MrScottFletcher/project-derek/qlcplus/Derek-Animation-Catalog-v03.md

# Derek animation catalog v03 â€” independent U1, U2, and U3 vibe libraries

v03 contains the same 51 one-shot vibe chasers for each universe: `LIB U1 Vibe`, `LIB U2 Vibe`, and `LIB U3 Vibe`. Each instance is independent and controls only its own cluster controller plus its eight Derek fixtures.

## Operator controls

- The existing `Animation Library - U1 Pilot` page remains available for U1 pilot functions.
- `Vibe Library - U1`, `Vibe Library - U2`, and `Vibe Library - U3` Virtual Console pages each provide Park/Blackout plus all 51 vibe buttons.
- Do not run two functions for the same universe at the same time. Different universe functions can run independently.

## Content and timing

Each universe has Angry, Aggressive, Nervous, Happy, Fun, Celebration, Reverent, Sad, Welcoming, Chaotic, Cheering, Zombie, Super Hero, Patriotic, Playful, Rainbow Fun, and Sparkle Ponies; each has three variations. Cue steps are at most 3.6 seconds and variations run approximately 10, 15, or 22 seconds. Every chaser ends in that universe's Park/Blackout pose.

## Required commissioning

U2 and U3 use raw DMX center 128 and the U1 physical direction convention (192 = left; 64 = right) as initial generated values. These are **not physically verified U2/U3 calibrations**. Before live playback, run each universe's Park/Blackout and a short vibe with clear mechanical travel, then record and apply any per-Derek center/direction corrections.
