MrScottFletcher/project-derek/qlcplus/Derek-Animation-Catalog-v04.md

# Derek animation catalog v04 â€” all-universe scenes

v04 retains all independent U1/U2/U3 libraries and adds 51 all-universe **SCENE** functions. Each is a QLC+ Show with three parallel tracks: U1 begins first, U2 follows after a small offset, and U3 follows after twice that offset. This makes the clusters feel independently active while using the same named vibe and variation. No QLC+ audio functions or cluster audio triggers are included.

Use the Scene Library - All Universes Virtual Console page for PARK ALL / BLACKOUT and the 51 themed scenes. Do not launch a scene alongside an independent function for U1, U2, or U3, because they own the same channels.

| Scene ID | Vibe | Variation | Name | U2/U3 offset | Total runtime |
| ---: | --- | ---: | --- | ---: | ---: || 1115 | Aggressive | 1 | Challenge | 500 ms | 10.7 s |
| 1116 | Aggressive | 2 | Charge | 900 ms | 16.6 s |
| 1117 | Aggressive | 3 | Dominance | 1300 ms | 24.9 s |
| 1118 | Angry | 1 | Glare | 500 ms | 10.7 s |
| 1119 | Angry | 2 | Boil | 900 ms | 16.6 s |
| 1120 | Angry | 3 | Red Storm | 1300 ms | 24.9 s |
| 1121 | Celebration | 1 | Gold Rise | 500 ms | 10.7 s |
| 1122 | Celebration | 2 | Confetti Sweep | 900 ms | 16.6 s |
| 1123 | Celebration | 3 | Grand Toast | 1300 ms | 24.9 s |
| 1124 | Chaotic | 1 | Mayhem | 500 ms | 10.7 s |
| 1125 | Chaotic | 2 | Crossfire | 900 ms | 16.6 s |
| 1126 | Chaotic | 3 | Everything Everywhere | 1300 ms | 24.9 s |
| 1127 | Cheering | 1 | Go Team | 500 ms | 10.7 s |
| 1128 | Cheering | 2 | Victory Wave | 900 ms | 16.6 s |
| 1129 | Cheering | 3 | Roar | 1300 ms | 24.9 s |
| 1130 | Fun | 1 | Wiggle | 500 ms | 10.7 s |
| 1131 | Fun | 2 | Color Chase | 900 ms | 16.6 s |
| 1132 | Fun | 3 | Party Peek | 1300 ms | 24.9 s |
| 1133 | Happy | 1 | Sunrise | 500 ms | 10.7 s |
| 1134 | Happy | 2 | Bouncy Hello | 900 ms | 16.6 s |
| 1135 | Happy | 3 | Bright Smile | 1300 ms | 24.9 s |
| 1136 | Nervous | 1 | Fidget | 500 ms | 10.7 s |
| 1137 | Nervous | 2 | Worry Scan | 900 ms | 16.6 s |
| 1138 | Nervous | 3 | Jitter | 1300 ms | 24.9 s |
| 1139 | Patriotic | 1 | Stars | 500 ms | 10.7 s |
| 1140 | Patriotic | 2 | Stripes | 900 ms | 16.6 s |
| 1141 | Patriotic | 3 | Finale | 1300 ms | 24.9 s |
| 1142 | Playful | 1 | Peekaboo | 500 ms | 10.7 s |
| 1143 | Playful | 2 | Tease | 900 ms | 16.6 s |
| 1144 | Playful | 3 | Goofy Wave | 1300 ms | 24.9 s |
| 1145 | Rainbow Fun | 1 | Rainbow Hello | 500 ms | 10.7 s |
| 1146 | Rainbow Fun | 2 | Prism Parade | 900 ms | 16.6 s |
| 1147 | Rainbow Fun | 3 | Rainbow Riot | 1300 ms | 24.9 s |
| 1148 | Reverent | 1 | Candle Watch | 500 ms | 10.7 s |
| 1149 | Reverent | 2 | Quiet Vigil | 900 ms | 16.6 s |
| 1150 | Reverent | 3 | Procession | 1300 ms | 24.9 s |
| 1151 | Sad | 1 | Blue Sigh | 500 ms | 10.7 s |
| 1152 | Sad | 2 | Lonely Look | 900 ms | 16.6 s |
| 1153 | Sad | 3 | Rainfall | 1300 ms | 24.9 s |
| 1154 | Sparkle Ponies | 1 | Twinkle Trot | 500 ms | 10.7 s |
| 1155 | Sparkle Ponies | 2 | Magic Mane | 900 ms | 16.6 s |
| 1156 | Sparkle Ponies | 3 | Glitter Gallop | 1300 ms | 24.9 s |
| 1157 | Super Hero | 1 | Hero Rise | 500 ms | 10.7 s |
| 1158 | Super Hero | 2 | Sky Patrol | 900 ms | 16.6 s |
| 1159 | Super Hero | 3 | Power Pose | 1300 ms | 24.9 s |
| 1160 | Welcoming | 1 | Warm Hello | 500 ms | 10.7 s |
| 1161 | Welcoming | 2 | Open House | 900 ms | 16.6 s |
| 1162 | Welcoming | 3 | Come Closer | 1300 ms | 24.9 s |
| 1163 | Zombie | 1 | Crawl | 500 ms | 10.7 s |
| 1164 | Zombie | 2 | Graveyard Scan | 900 ms | 16.6 s |
| 1165 | Zombie | 3 | Undead Swarm | 1300 ms | 24.9 s |

## Audio handoff

The scene timing above is intentionally independent of audio. Add a QLC+ audio function or a cluster-controller DFPlayer trigger to a fourth Show track when the track numbers and desired cue points are confirmed. Preserve the existing three motion tracks and their stagger offsets.
