MrScottFletcher/project-derek/3d-files/DerekCanLidAssembly_75_v1_Ring_v8-Perfect-for-some-cans.stl

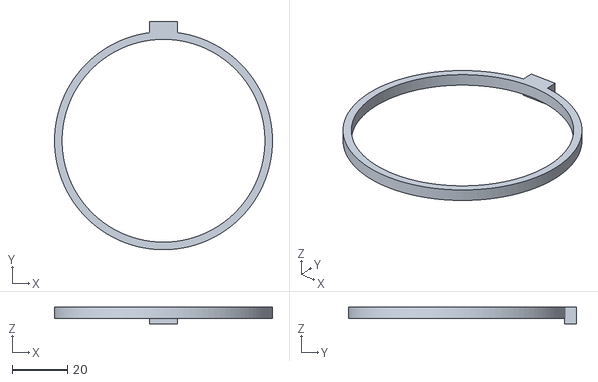
[picture p1: CAD file, 2026-08-20]
3d-files/DerekCanLidAssembly_75_v1_Ring_v8-Perfect-for-some-cans.stl
79.0 x 82.8 x 6.00
