MrScottFletcher/project-derek/3d-files/DerekCanLidAssembly_75_v1_Ring_v10_x3.3mf

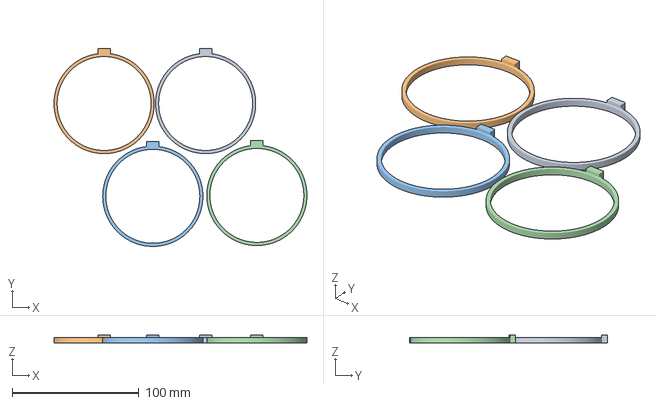
[picture p2: CAD file, 2026-08-20]
3d-files/DerekCanLidAssembly_75_v1_Ring_v10_x3.3mf
199.4 x 155.9 x 6.00 mm
DerekCanLidAssembly_75_v1_Ring_v10.stl x 4
