MrScottFletcher/project-derek/3d-files/DerekCanLidAssembly_85_v1 v17_1mm_Trans_qty1.3mf

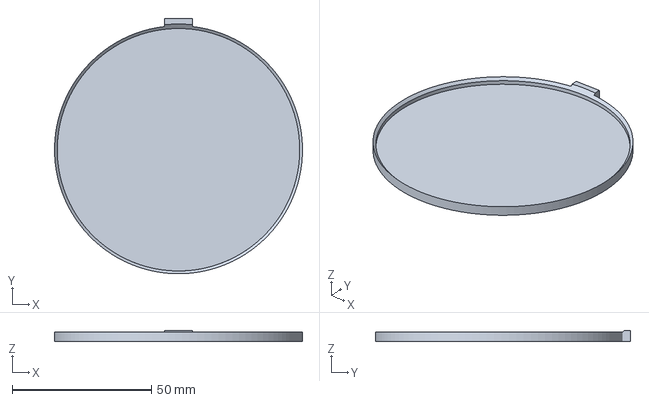
[picture p3: CAD file, 2026-08-20]
3d-files/DerekCanLidAssembly_85_v1 v17_1mm_Trans_qty1.3mf
89.0 x 91.6 x 4.00 mm
