MrScottFletcher/project-derek/3d-files/DerekCanLidAssembly_75_v1_Lid_v6_x4.3mf

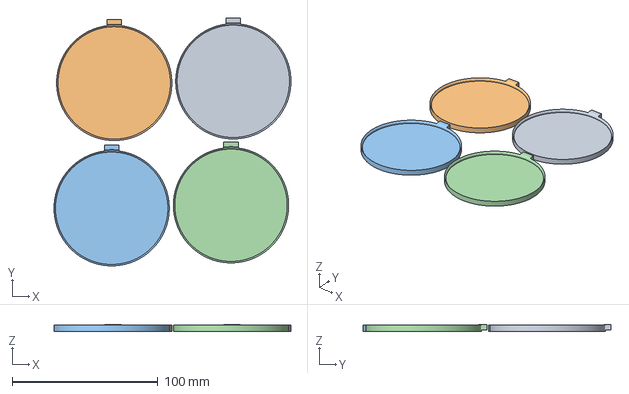
[picture p4: CAD file, 2026-08-20]
3d-files/DerekCanLidAssembly_75_v1_Lid_v6_x4.3mf
162.3 x 169.8 x 5.00 mm
DerekCanLidAssembly_75_v1_Lid_v6.stl x 4
