MrScottFletcher/project-derek/3d-files/Chassis Derek Can Assembly 1 v17 - qty07- 1mm new clearance.3mf

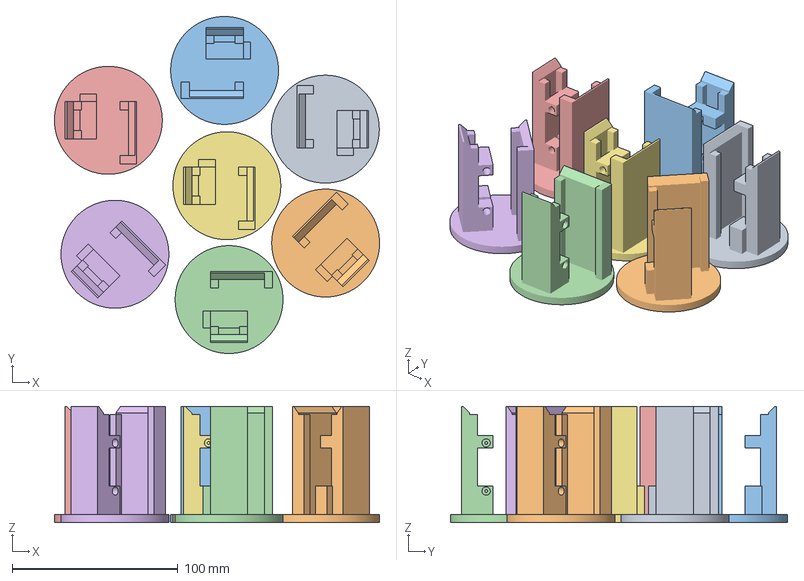
[picture p5: CAD file, 2026-08-20]
3d-files/Chassis Derek Can Assembly 1 v17 - qty07- 1mm new clearance.3mf
195.9 x 203.1 x 70.0 mm
Carriage Derek Can Assembly 1 v17 - 1mm new clearance.stl
Carriage Derek Can Assembly 1 v17 - 1mm new clearance.stl 1
Carriage Derek Can Assembly 1 v17 - 1mm new clearance.stl 2 x 2
Carriage Derek Can Assembly 1 v17 - 1mm new clearance.stl 3
Carriage Derek Can Assembly 1 v17 - 1mm new clearance.stl 4
Carriage Derek Can Assembly 1 v17 - 1mm new clearance.stl 5
