MrScottFletcher/project-derek/3d-files/DerekCanLidAssembly_85_v1_Ring_v15_x3.3mf

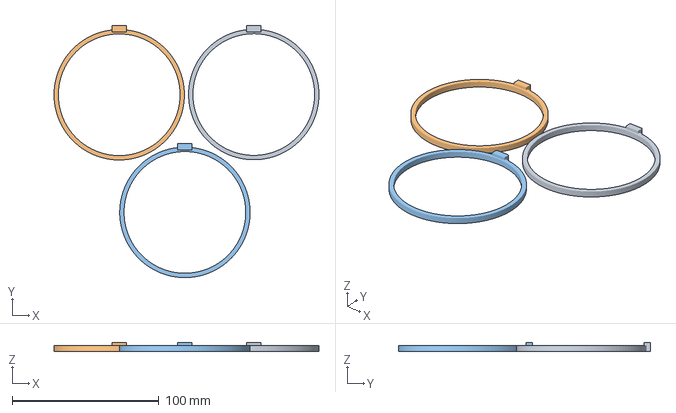
[picture p6: CAD file, 2026-08-20]
3d-files/DerekCanLidAssembly_85_v1_Ring_v15_x3.3mf
180.8 x 172.0 x 6.00 mm
DerekCanLidAssembly_85_v1_Ring_v15.stl x 3
