MrScottFletcher/project-derek/3d-files/DerekCanLidAssembly_75_v1_Lid_v11_1mmThick_Transparent_01.3mf

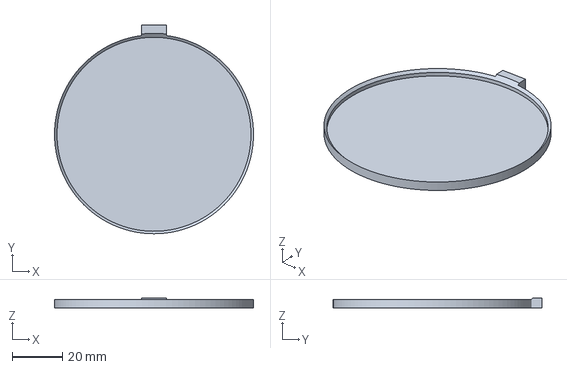
[picture p7: CAD file, 2026-08-20]
3d-files/DerekCanLidAssembly_75_v1_Lid_v11_1mmThick_Transparent_01.3mf
79.0 x 82.8 x 4.00 mm
