MrScottFletcher/project-derek/3d-files/Carriage Derek Can Assembly 1 v17 - 1mm new clearance.3mf

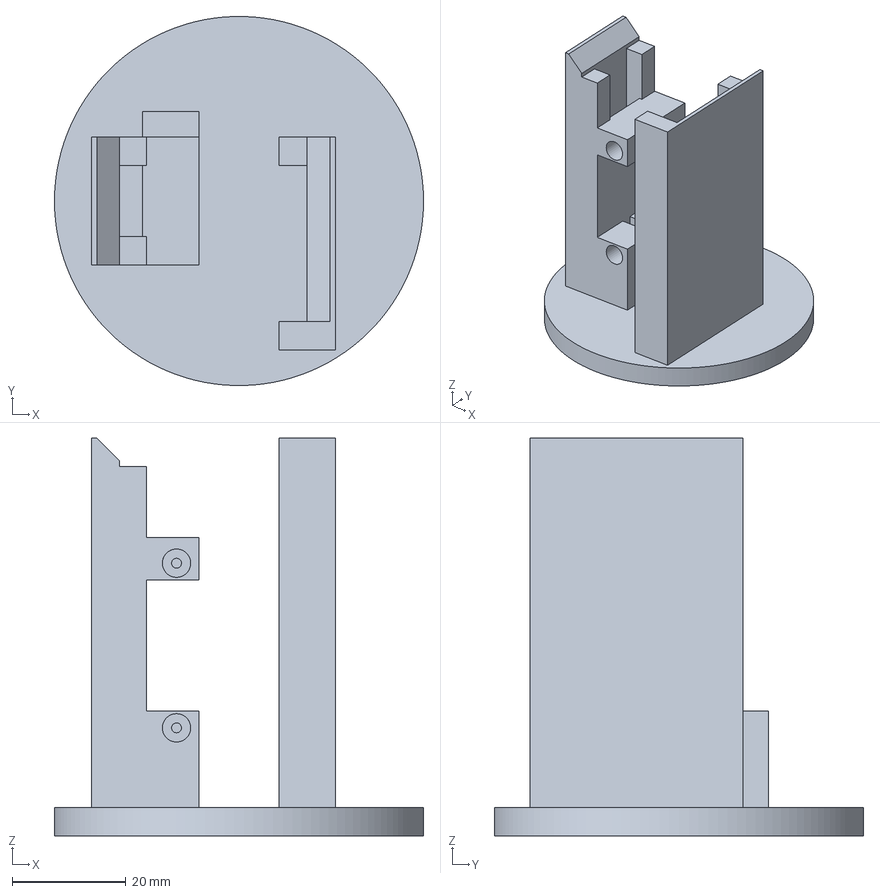
[picture p8: CAD file, 2026-08-20]
3d-files/Carriage Derek Can Assembly 1 v17 - 1mm new clearance.3mf
65.0 x 65.0 x 70.0 mm
