MrScottFletcher/project-derek/3d-files/DerekCanLidAssembly_85_v1_Lid_v15_Trans_x3.3mf

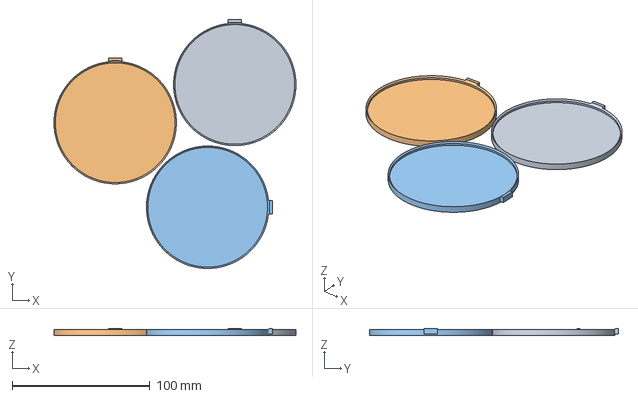
[picture p9: CAD file, 2026-08-20]
3d-files/DerekCanLidAssembly_85_v1_Lid_v15_Trans_x3.3mf
175.9 x 181.0 x 5.00 mm
DerekCanLidAssembly_85_v1_Lid_v15.stl x 3
