MrScottFletcher/project-derek/3d-files/DerekCanLidAssembly_75_v1_Ring_v8_x3-Perfect-for-some-cans.stl.3mf

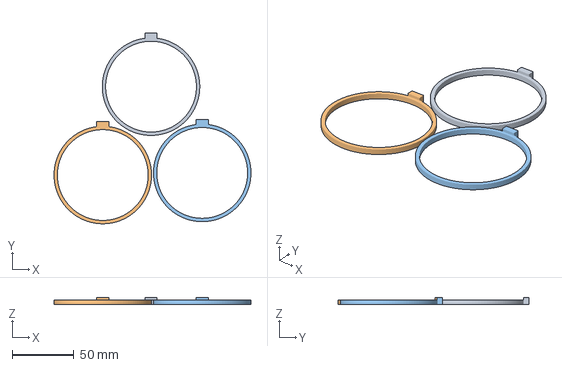
[picture p10: CAD file, 2026-08-20]
3d-files/DerekCanLidAssembly_75_v1_Ring_v8_x3-Perfect-for-some-cans.stl.3mf
159.5 x 154.4 x 6.00 mm
DerekCanLidAssembly_75_v1_Ring_v8.stl x 3
