MrScottFletcher/project-derek/3d-files/DerekCanLidAssembly_85_v1_Ring_v15.3mf

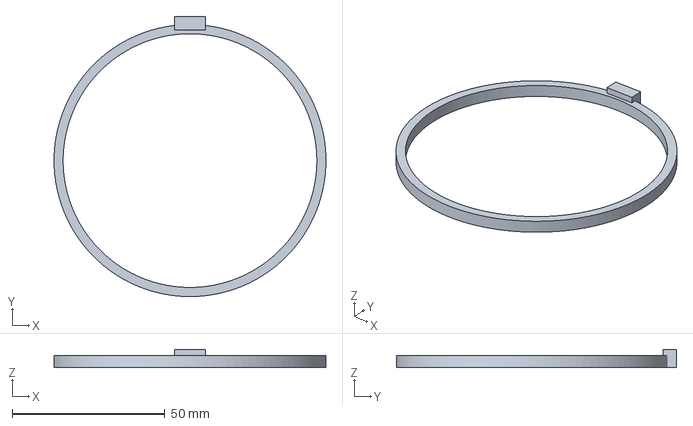
[picture p11: CAD file, 2026-08-20]
3d-files/DerekCanLidAssembly_85_v1_Ring_v15.3mf
89.0 x 91.6 x 6.00 mm
