MrScottFletcher/project-derek/3d-files/DerekCanLidAssembly_85_v1_Lid_v15_Trans_x1.3mf

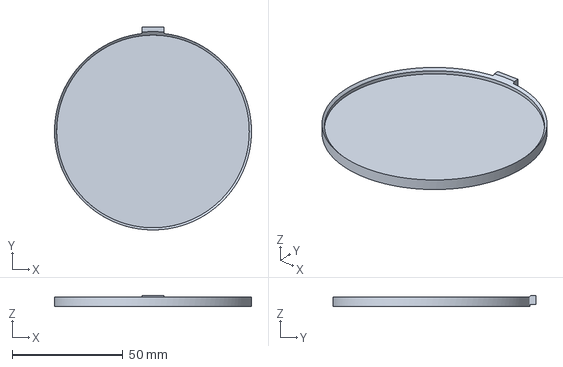
[picture p12: CAD file, 2026-08-20]
3d-files/DerekCanLidAssembly_85_v1_Lid_v15_Trans_x1.3mf
89.0 x 91.7 x 5.00 mm
