MrScottFletcher/project-derek/3d-files/DerekCanLidAssembly_75_v1_Ring_v9.3mf

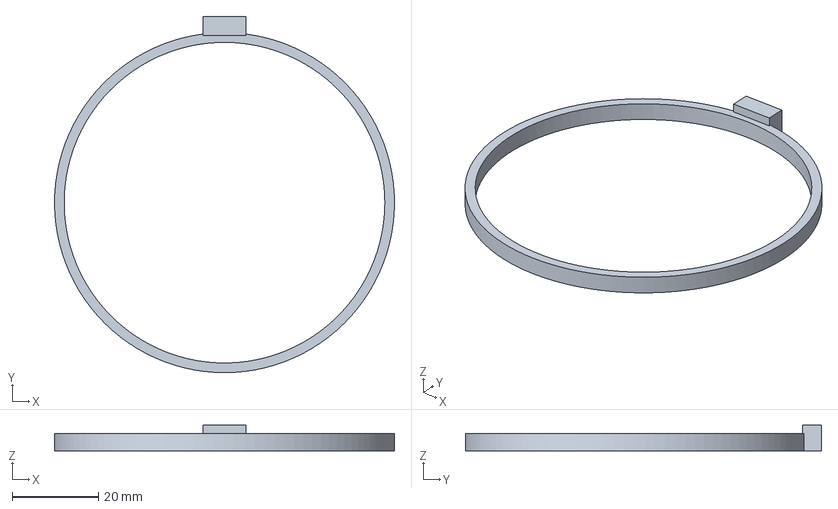
[picture p13: CAD file, 2026-08-20]
3d-files/DerekCanLidAssembly_75_v1_Ring_v9.3mf
79.0 x 82.8 x 6.00 mm
