MrScottFletcher/project-derek/3d-files/Chassis Derek Can Assembly 1 v19 qty7 - more space for carriage.3mf

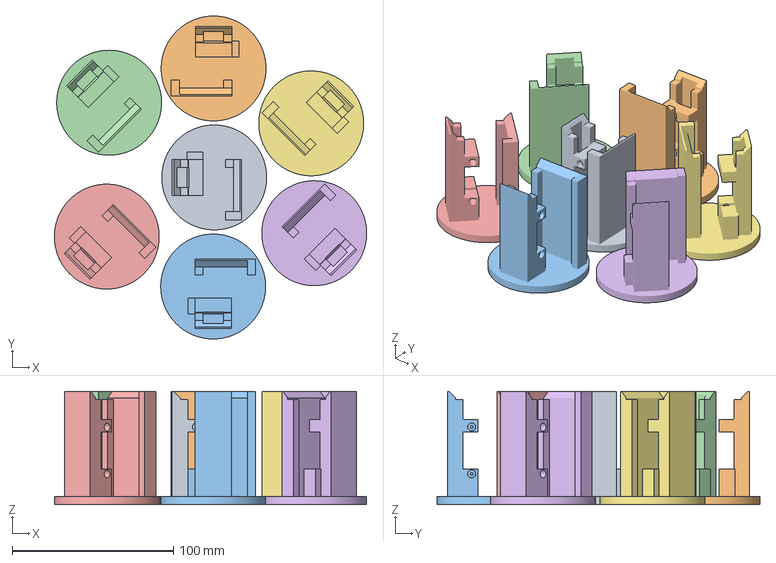
[picture p14: CAD file, 2026-08-20]
3d-files/Chassis Derek Can Assembly 1 v19 qty7 - more space for carriage.3mf
193.5 x 200.1 x 70.0 mm
Chassis Derek Can Assembly 1 v19 - more space for carriage.stl x 7
