MrScottFletcher/project-derek/3d-files/Spur Gear 15 Derek Can Assembly 1 v15.stl

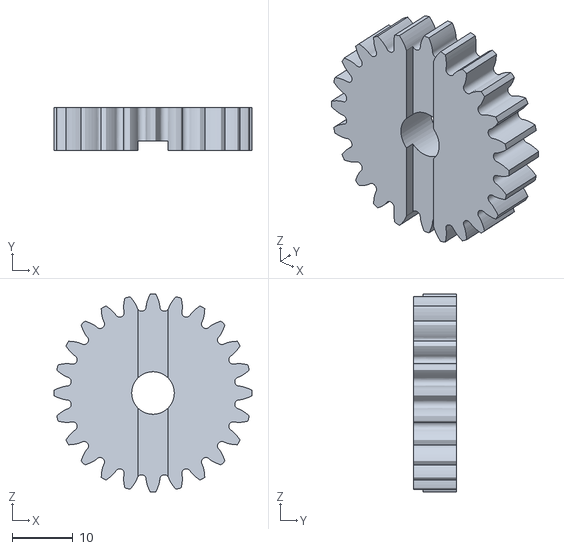
[picture p16: CAD file, 2026-08-07]
3d-files/Spur Gear 15 Derek Can Assembly 1 v15.stl
32.5 x 7.00 x 32.5
