MrScottFletcher/project-derek/3d-files/DerekCanLidAssembly_75_v1_Lid_v6.stl

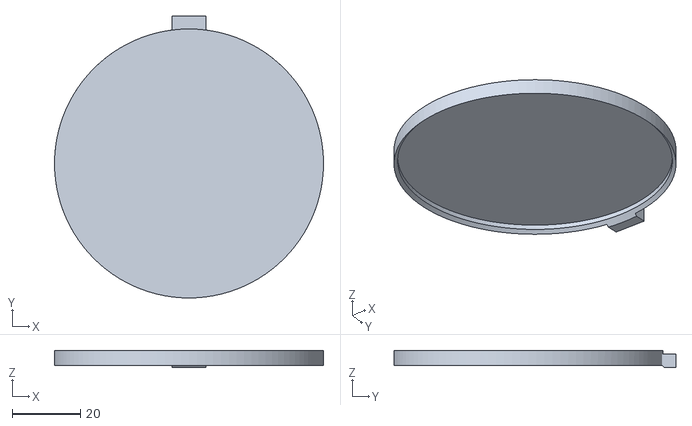
[picture p17: CAD file, 2026-08-07]
3d-files/DerekCanLidAssembly_75_v1_Lid_v6.stl
79.0 x 82.8 x 5.00
