MrScottFletcher/project-derek/3d-files/Mech_Carriage 15 Derek Can Assembly 1 v15.stl

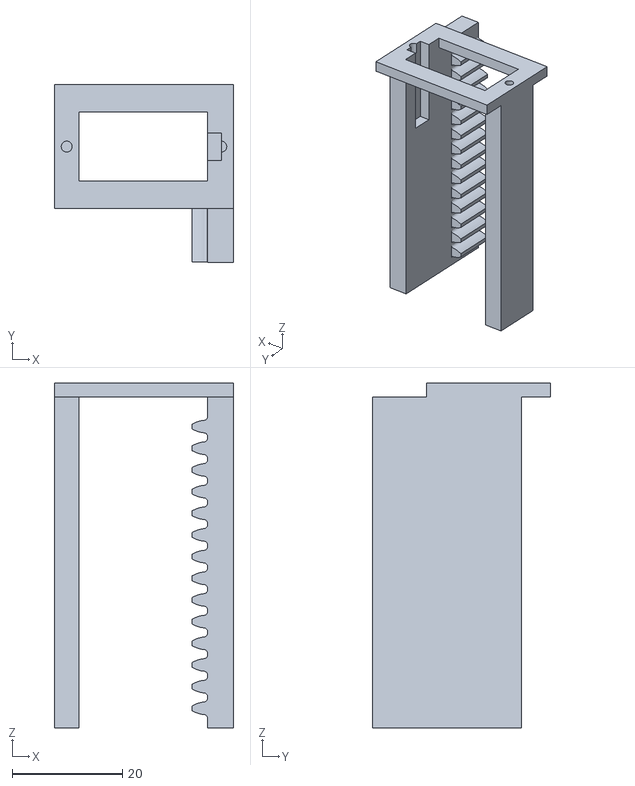
[picture p18: CAD file, 2026-08-07]
3d-files/Mech_Carriage 15 Derek Can Assembly 1 v15.stl
32.5 x 32.2 x 62.5
