MrScottFletcher/project-derek/3d-files/DerekCan_Platform_75_SpotWIRECover_v11.stl

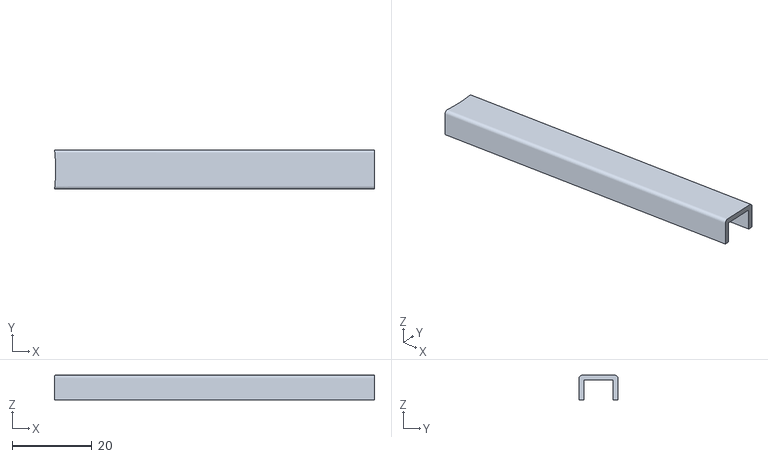
[picture p20: CAD file, 2026-09-27]
3d-files/DerekCan_Platform_75_SpotWIRECover_v11.stl
80.5 x 9.80 x 6.20
