MrScottFletcher/project-derek/3d-files/DerekCan_Platform_75 v5.stl

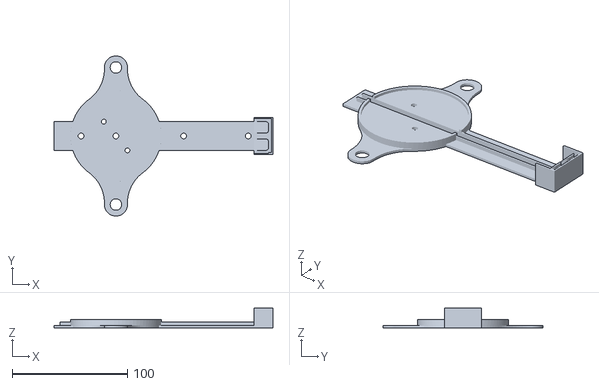
[picture p21: CAD file, 2026-09-27]
3d-files/DerekCan_Platform_75 v5.stl
190.2 x 139.0 x 17.0
