MrScottFletcher/project-derek/3d-files/Cluster Board Mount Plate v5 220x220.stl

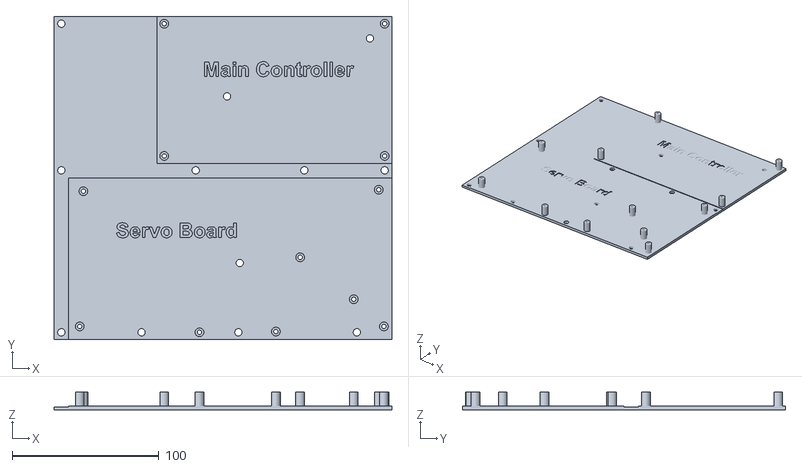
[picture p22: CAD file, 2026-09-27]
3d-files/Cluster Board Mount Plate v5 220x220.stl
230.0 x 220.0 x 12.0
