MrScottFletcher/project-derek/3d-files/Servo Horn EyeCoil_A v9 CloserToPin_qty33.3mf

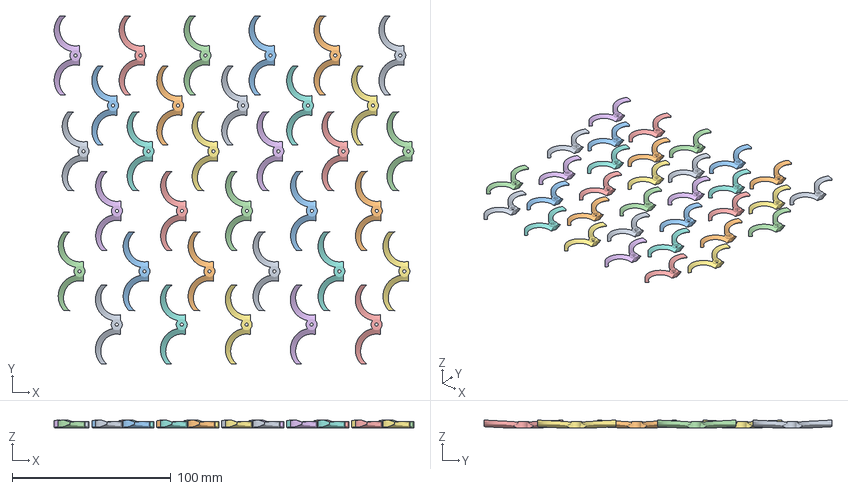
[picture p23: CAD file, 2026-09-27]
3d-files/Servo Horn EyeCoil_A v9 CloserToPin_qty33.3mf
226.5 x 219.1 x 5.08 mm
Servo Horn EyeCoil_A v9 CloserToPin.stl x 6
Servo Horn EyeCoil_A v9 CloserToPin.stl 1 x 6
Servo Horn EyeCoil_A v9 CloserToPin.stl 4 x 6
Servo Horn EyeCoil_A v9 CloserToPin.stl 6 x 6
Servo Horn EyeCoil_A v9 CloserToPin.stl 11 x 6
Servo Horn EyeCoil_A v9 CloserToPin.stl 14 x 3
