MrScottFletcher/project-derek/3d-files/Audio Amp Box A v3.stl

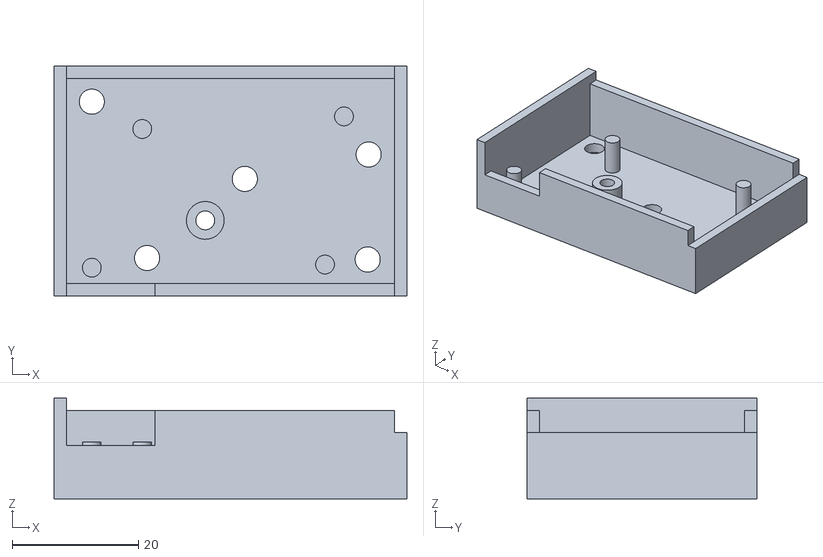
[picture p24: CAD file, 2026-09-27]
3d-files/Audio Amp Box A v3.stl
56.0 x 36.5 x 16.0
