MrScottFletcher/project-derek/3d-files/DerekCan_Platform_75_SpotCover_NoOverhang_ v13.stl

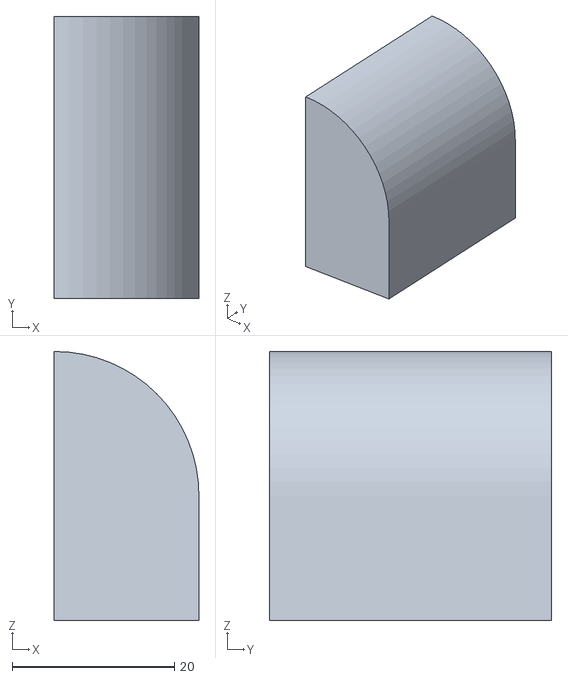
[picture p25: CAD file, 2026-09-27]
3d-files/DerekCan_Platform_75_SpotCover_NoOverhang_ v13.stl
17.9 x 34.8 x 33.2
