MrScottFletcher/project-derek/3d-files/Servo Horn EyeCoil_A v9 CloserToPin.stl

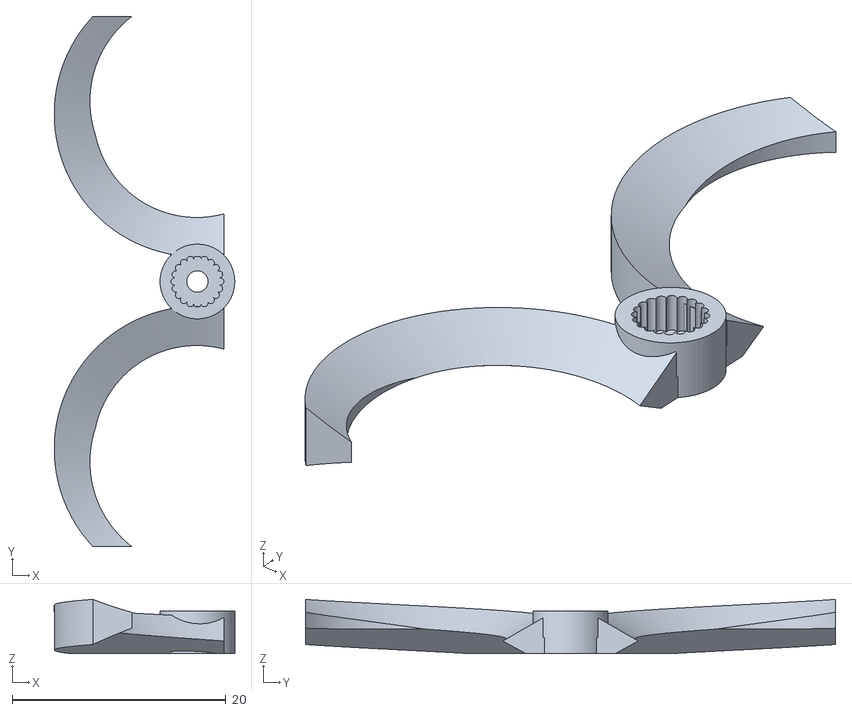
[picture p26: CAD file, 2026-09-27]
3d-files/Servo Horn EyeCoil_A v9 CloserToPin.stl
16.9 x 49.6 x 5.08
