MrScottFletcher/project-derek/3d-files/DerekCan_Platform_75 v5_qty2.3mf

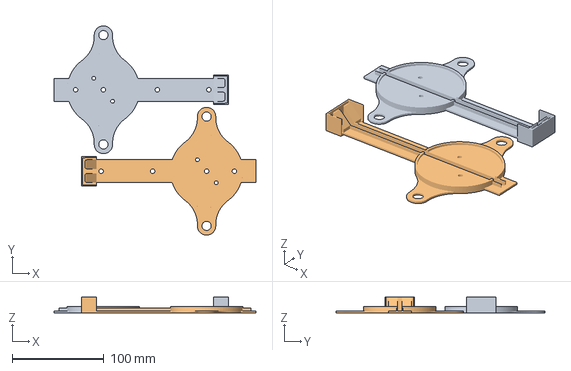
[picture p27: CAD file, 2026-09-27]
3d-files/DerekCan_Platform_75 v5_qty2.3mf
219.9 x 227.7 x 17.0 mm
DerekCan_Platform_75 v5.stl x 2
