MrScottFletcher/project-derek/3d-files/Servo Horn EyeCoil_A v8 Flattish.stl

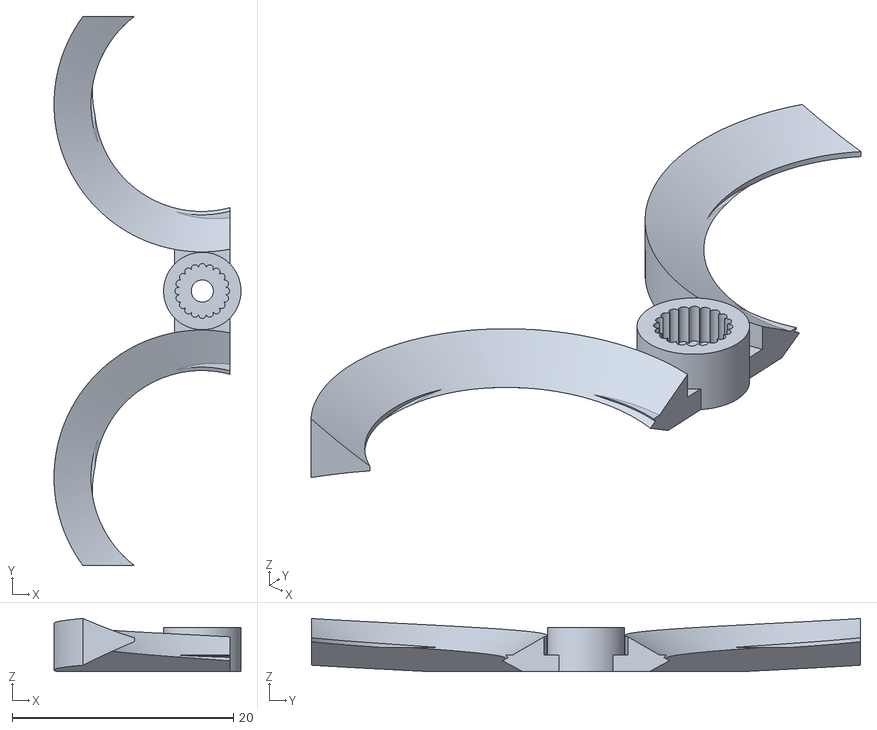
[picture p28: CAD file, 2026-09-27]
3d-files/Servo Horn EyeCoil_A v8 Flattish.stl
16.9 x 49.6 x 4.80
