MrScottFletcher/project-derek/3d-files/Servo Horn Eye Mount v4 xLots.3mf

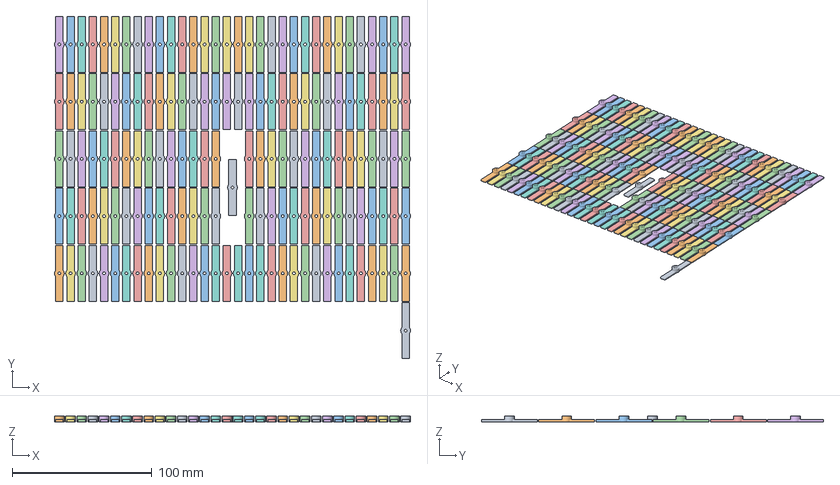
[picture p29: CAD file, 2026-08-20]
3d-files/Servo Horn Eye Mount v4 xLots.3mf
255.0 x 245.0 x 4.00 mm
Servo Horn Eye Mount v4 Test1.stl
Servo Horn Eye Mount v4 Test1.stl -1 x 157
