MrScottFletcher/project-derek/3d-files/Servo Horn Pinion Gear Mount v1.stl

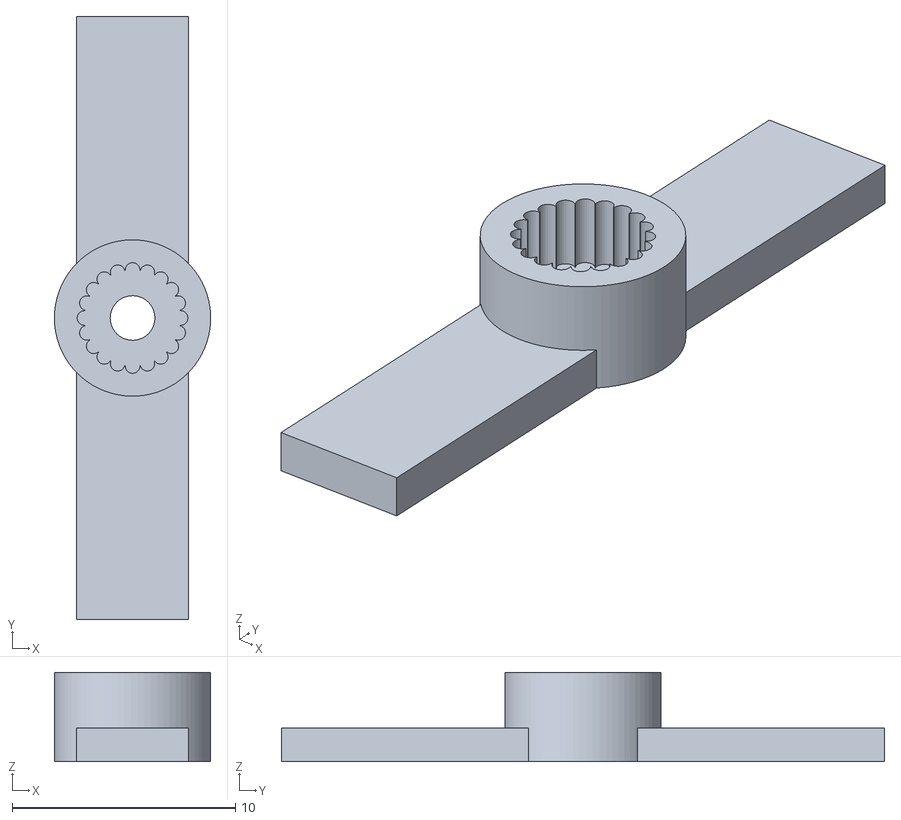
[picture p30: CAD file, 2026-08-20]
3d-files/Servo Horn Pinion Gear Mount v1.stl
7.00 x 27.0 x 4.00
