MrScottFletcher/project-derek/3d-files/Servo Horn Eye Mount ExtendedHub v1 v1.stl

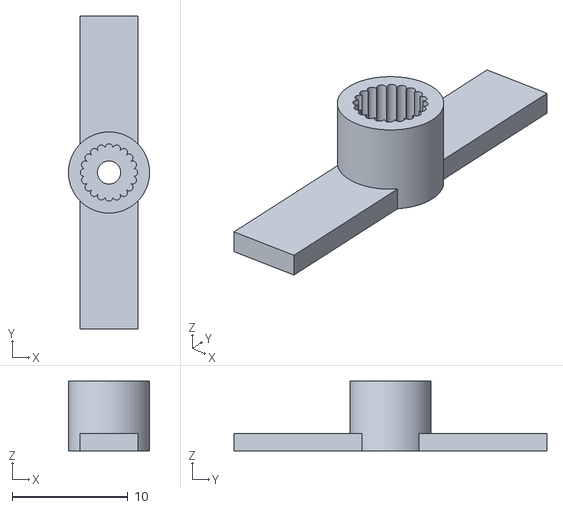
[picture p31: CAD file, 2026-08-20]
3d-files/Servo Horn Eye Mount ExtendedHub v1 v1.stl
7.00 x 27.0 x 6.00
