MrScottFletcher/project-derek/(list of files, cad)

Other CAD files:
3d-files/DerekCanLidAssembly_75_v1_Ring_v8-Perfect-for-some-cans.stl.3mf
3d-files/Chassis Derek Can Assembly 1 v17 - 1mm new clearance.3mf
3d-files/DerekCanLidAssembly_85_v1_Lid_v15.3mf
3d-files/Chassis Derek Can Assembly 1 v19 - more space for carriage.3mf
3d-files/Mech_Chassis 15 Derek Can Assembly 1 v15.stl
3d-files/Chassis Derek Can Assembly 1 v17 - 1mm new clearance.stl
3d-files/Chassis Derek Can Assembly 1 v19 - more space for carriage.stl
3d-files/DerekCanLidAssembly_75_v1_Ring_v10.stl
3d-files/DerekCanLidAssembly_75_v1_Ring_v9.stl
3d-files/DerekCanLidAssembly_85_v1_Lid_v15.stl
3d-files/DerekCanLidAssembly_85_v1_Ring_v15.stl
