MrScottFletcher/project-derek/print/MrLabel_MR610_LibreOffice.odt

Mr-Label

Mr-Label

Mr-Label

Mr-Label

Mr-Label

Mr-Label

Mr-Label

Mr-Label

Mr-Label

Mr-Label

Mr-Label

Mr-Label

Mr-Label

Mr-Label

Mr-Label

Mr-Label

Mr-Label

Mr-Label

Mr-Label

Mr-Label

Mr-Label

Mr-Label

Mr-Label

Mr-Label

Mr-Label

Mr-Label

Mr-Label

Mr-Label

Mr-Label

Mr-Label

Mr-Label

Mr-Label

Mr-Label

Mr-Label

Mr-Label

Mr-Label

Mr-Label

Mr-Label

Mr-Label

Mr-Label

Mr-Label

Mr-Label

Mr-Label

Mr-Label

Mr-Label

Mr-Label

Mr-Label

Mr-Label

Mr-Label

Mr-Label

Mr-Label

Mr-Label

Mr-Label

Mr-Label

Mr-Label

Mr-Label

Mr-Label

Mr-Label

Mr-Label

Mr-Label

Mr-Label

Mr-Label

Mr-Label

Mr-Label
