MrScottFletcher/project-derek/print/MrLabel_MR610_LibreOffice_CanLabels_U1-4.odt

U1 -1

U1 -1

U1 -2

U1 -2

U1 -3

U1 -3

U1 -4

U1 -4

U1 -5

U1 -5

U1 -6

U1 -6

U1 -7

U1 -7

U1 -8

U1 -8

U2 -1

U2 -1

U2 -2

U2 -2

U2 -3

U2 -3

U2 -4

U2 -4

U2 -5

U2 -5

U2 -6

U2 -6

U2 -7

U2 -7

U2 -8

U2 -8

U3 -1

U3 -1

U3 -2

U3 -2

U3 -3

U3 -3

U3 -4

U3 -4

U3 -5

U3 -5

U3 -6

U3 -6

U3 -7

U3 -7

U3 -8

U3 -8

U4 -1

U4 -1

U4 -2

U4 -2

U4 -3

U4 -3

U4 -4

U4 -4

U4 -5

U4 -5

U4 -6

U4 -6

U4 -7

U4 -7

U4 -8

U4 -8
