MrScottFletcher/project-derek/print/MrLabel_MR610_LibreOffice_CanLabels_U5-8.odt

U5 -1

U5 -1

U5 -2

U5 -2

U5 -3

U5 -3

U5 -4

U5 -4

U5 -5

U5 -5

U5 -6

U5 -6

U5 -7

U5 -7

U5 -8

U5 -8

U6 -1

U6 -1

U6 -2

U6 -2

U6 -3

U6 -3

U6 -4

U6 -4

U6 -5

U6 -5

U6 -6

U6 -6

U6 -7

U6 -7

U6 -8

U6 -8

U7 -1

U7 -1

U7 -2

U7 -2

U7 -3

U7 -3

U7 -4

U7 -4

U7 -5

U7 -5

U7 -6

U7 -6

U7 -7

U7 -7

U7 -8

U7 -8

U8 -1

U8 -1

U8 -2

U8 -2

U8 -3

U8 -3

U8 -4

U8 -4

U8 -5

U8 -5

U8 -6

U8 -6

U8 -7

U8 -7

U8 -8

U8 -8
