MrScottFletcher/project-derek/print/MrLabel_MR610_LibreOffice_Spaced.odt

Mr-Label

Mr-Label

Mr-Label

Mr-Label

Mr-Label

Mr-Label

Mr-Label

Mr-Label

Mr-Label

Mr-Label

Mr-Label

Mr-Label

Mr-Label

Mr-Label

Mr-Label

Mr-Label

Mr-Label

Mr-Label

Mr-Label

Mr-Label

Mr-Label

Mr-Label

Mr-Label

Mr-Label

Mr-Label

Mr-Label

Mr-Label

Mr-Label

Mr-Label

Mr-Label

Mr-Label

Mr-Label

Mr-Label

Mr-Label

Mr-Label

Mr-Label

Mr-Label

Mr-Label

Mr-Label

Mr-Label

Mr-Label

Mr-Label

Mr-Label

Mr-Label

Mr-Label

Mr-Label

Mr-Label

Mr-Label

Mr-Label

Mr-Label

Mr-Label

Mr-Label

Mr-Label

Mr-Label

Mr-Label

Mr-Label

Mr-Label

Mr-Label

Mr-Label

Mr-Label

Mr-Label

Mr-Label

Mr-Label

Mr-Label
