MrScottFletcher/project-derek/kicad/derek-can-pcb/Derek_CAN_v4.kicad_pcb

## KiCad design kicad/derek-can-pcb/Derek_CAN_v4.kicad_pcb (2026-08-16)

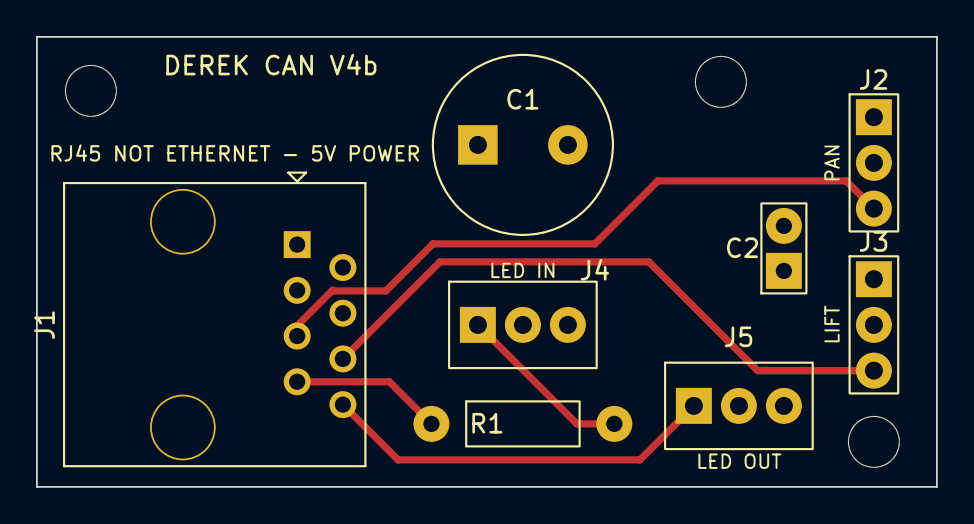
[picture p43: board Derek_CAN_v4.kicad_pcb from above]

Board: 4 copper layers, 50.0 x 25.0 mm, 8 parts (0 on the bottom side), 7 nets.

Parts:
C1: 1000uF 16V; CP_Radial_D10.0mm_P5.00mm
C2: 100nF 50V X7R; C_Disc_D5.0mm_W2.5mm_P2.50mm
J1: FMHXG_RJ45NMCCFC; RJ45_OST_PJ012-8P8CX_Vertical
J2: PAN_SERVO; PinHeader_1x03_P2.54mm_Vertical
J3: LIFT_SERVO; PinHeader_1x03_P2.54mm_Vertical
J4, J5: JST-XH-3; JST_XH_B3B-XH-A_1x03_P2.50mm_Vertical
R1: 330R; R_Axial_DIN0207_L6.3mm_D2.5mm_P10.16mm_Horizontal

Connections:
5V: C1.1 (+), C2.1, J1.1, J1.2, J2.2 (+5V), J3.2 (+5V), J4.2 (+5V), J5.2 (+5V)
GND: C1.2 (-), C2.2, J1.3, J1.4, J2.1 (GND), J3.1 (GND), J4.3 (GND), J5.3 (GND)
LED_FROM_CLUSTER: J1.7, R1.1
LED_RETURN_CLUSTER: J1.8, J5.1 (DATA)
LED_TO_FIRST: J4.1 (DATA), R1.2
LIFT_PWM: J1.6, J3.3 (SIGNAL)
PAN_PWM: J1.5, J2.3 (SIGNAL)
