MrScottFletcher/project-derek/kicad/cluster_split_kicad_revC/Cluster_Logic_Board/Cluster_Logic_Board.kicad_pcb

## KiCad design kicad/cluster_split_kicad_revC/Cluster_Logic_Board/Cluster_Logic_Board.kicad_pcb (2026-08-16)

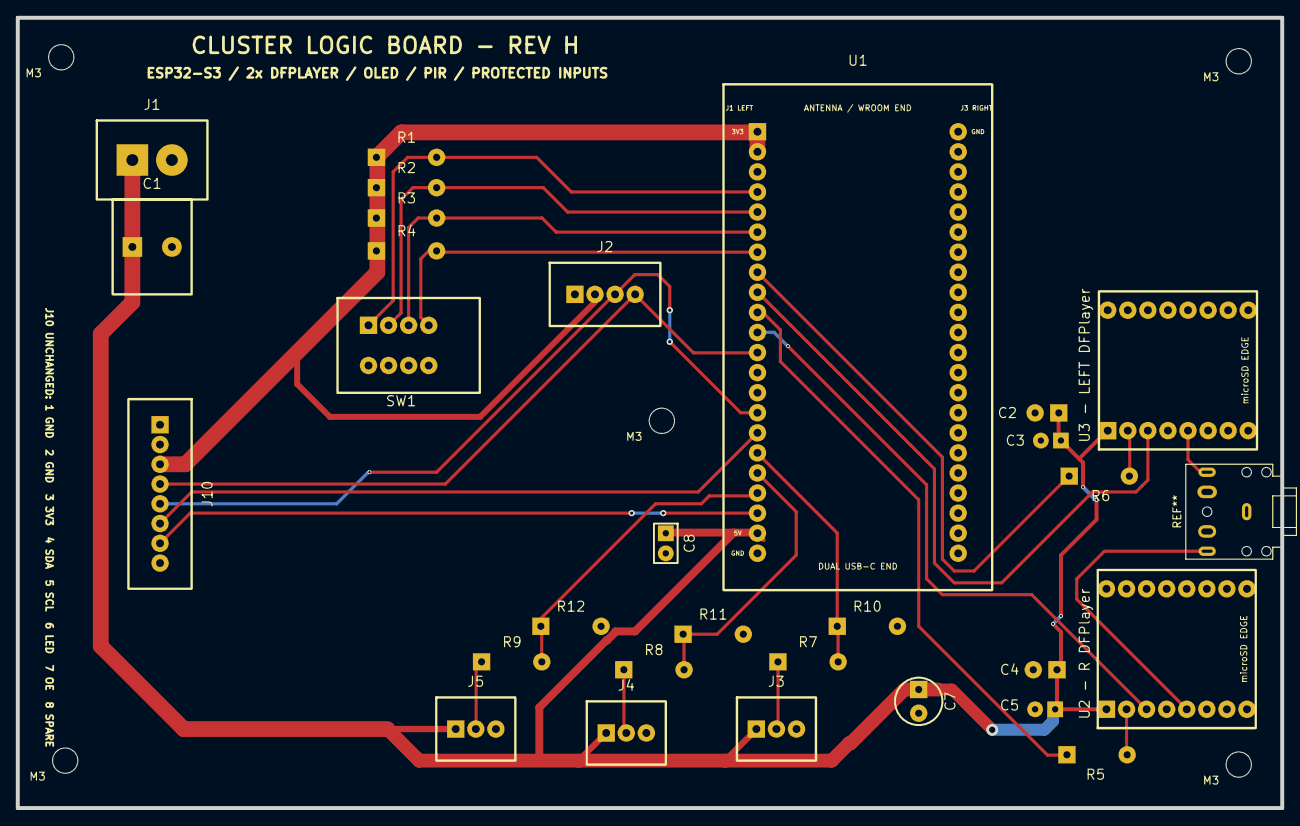
[picture p44: board Cluster_Logic_Board.kicad_pcb from above]

Board: 2 copper layers, 160.0 x 100.0 mm, 34 parts (0 on the bottom side), 23 nets.

Parts:
C1: 1000uF_10V
C2, C4: 47uF 10V; C_Radial_47uF
C3, C5: 100nF; C_Ceramic_100nF
C7: 47uF 10V ESP32; C_Radial_47uF
C8: 100nF ESP32; C_Ceramic_100nF
J1: POWER_5V
J2: OLED_1x4
J3: PIR_LEFT
J4: PIR_CENTER
J5: PIR_RIGHT
J10: JST_XH_8
M3, M3#2, M3#3, M3#4, M3#5: MountingHole_3.2mm_M3
R1, R2, R3, R4: 10k; R_Axial_10k
R5: 1k DF1 RX; R_Axial_1k
R6: 1k DF2 RX; R_Axial_1k
R7: 1k PIR L; R_Axial_1k
R8: 1k PIR C; R_Axial_1k
R9: 1k PIR R; R_Axial_1k
R10, R11, R12: 100k; R_Axial_100k
SW1: DIPSW_4
U1: Hosyond ESP32-S3 N16R8 44-pin DevKit; Hosyond_ESP32-S3_N16R8_44P
U2 - R DFPlayer, U3 - LEFT DFPlayer: WWZMDiB DFPlayer Mini; DFPlayer_Mini_16P

Connections:
+3V3_LOGIC: J2.2, J10.3, R1.1, R2.1, R3.1, R4.1, U1.J1.1, U1.J1.2
+5V_LOGIC: C1.1, C2.1, C3.1, C4.1, C5.1, C7.1, C8.1, J1.1, J3.1, J4.1, J5.1, U1.J1.21, U2 - R DFPlayer.1, U3 - LEFT DFPlayer.1
DF1_RX: R5.2, U2 - R DFPlayer.2
DF1_RX_ESP: R5.1, U1.J1.10
DF1_TX: U1.J1.11, U2 - R DFPlayer.3
DF2_RX: R6.2, U3 - LEFT DFPlayer.2
DF2_RX_ESP: R6.1, U1.J1.8
DF2_TX: U1.J1.9, U3 - LEFT DFPlayer.3
GND: C1.2, C2.2, C3.2, C4.2, C5.2, C7.2, C8.2, J1.2, J2.1, J3.3, J4.3, J5.3, J10.1, J10.2, R10.2, R11.2, R12.2, SW1.5, SW1.6, SW1.7, SW1.8, U1.J1.22, U1.J3.1, U1.J3.21, U1.J3.22, U2 - R DFPlayer.7, U2 - R DFPlayer.10, U3 - LEFT DFPlayer.7, U3 - LEFT DFPlayer.10
I2C_SCL: J2.3, J10.5, U1.J1.15
I2C_SDA: J2.4, J10.4, U1.J1.12
ID0: R1.2, SW1.1, U1.J1.4
ID1: R2.2, SW1.2, U1.J1.5
ID2: R3.2, SW1.3, U1.J1.6
ID3: R4.2, SW1.4, U1.J1.7
LED_DATA_3V3: J10.6, U1.J1.16
PCA_OE_N: J10.7, U1.J1.20
PIR_CENTER: R8.2, R11.1, U1.J1.18
PIR_CENTER_CONN: J4.2, R8.1
PIR_LEFT: R7.2, R10.1, U1.J1.17
PIR_LEFT_CONN: J3.2, R7.1
PIR_RIGHT: R9.2, R12.1, U1.J1.19
PIR_RIGHT_CONN: J5.2, R9.1
