MrScottFletcher/project-derek/kicad/cluster_split_kicad_revC/Cluster_Servo_Board/Cluster_Servo_Board.kicad_pcb

## KiCad design kicad/cluster_split_kicad_revC/Cluster_Servo_Board/Cluster_Servo_Board.kicad_pcb (2026-08-16)

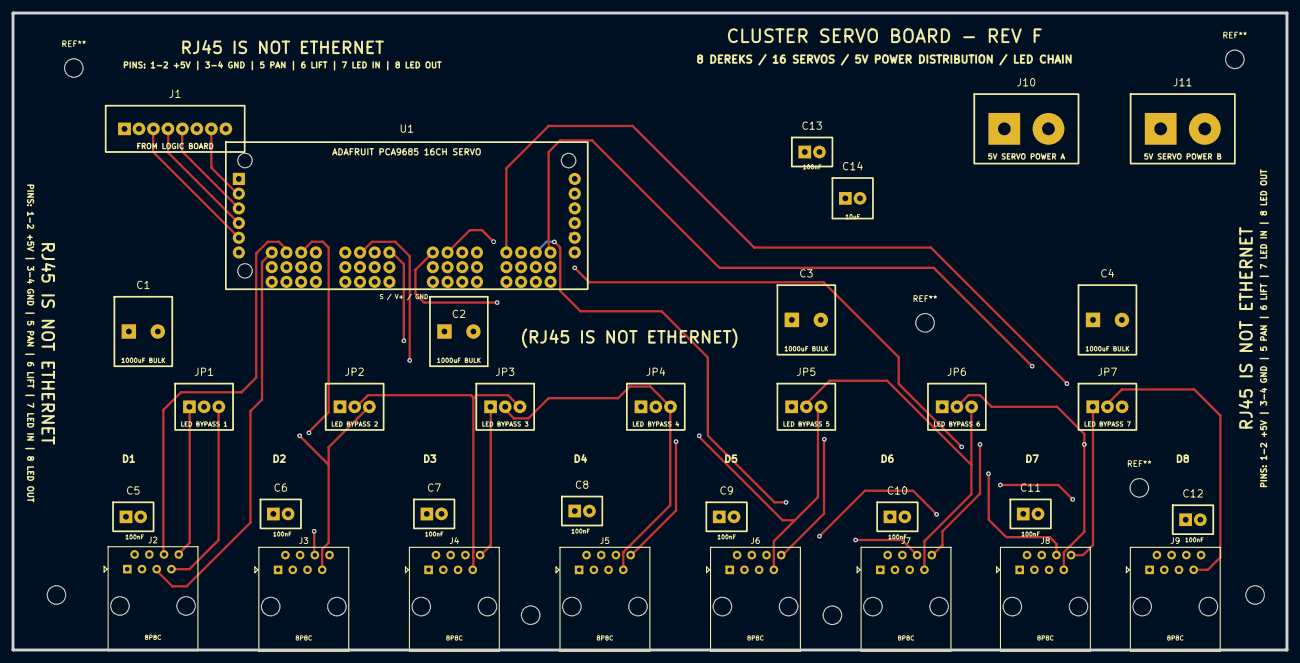
[picture p45: board Cluster_Servo_Board.kicad_pcb from above]

Board: 4 copper layers, 220.0 x 110.0 mm, 33 parts (0 on the bottom side), 37 nets.

Parts:
C1, C2, C3, C4: 1000uF_10V
C5, C6, C7, C8, C9, C10, C11, C12, C13: 100nF
C14: 10uF
J1: JST_XH_8
J2, J3, J4, J5, J6, J7, J8, J9: RJ45_Amphenol_54602-x08_Horizontal
J10, J11: POWER_5V_HICUR
JP1, JP2, JP3, JP4, JP5, JP6, JP7: LED_BYPASS
U1: ADAFRUIT_PCA9685_16CH_PRODUCT_815; Adafruit_PCA9685_16CH_Product815_Carrier

Connections:
+3V3_LOGIC: J1.3, U1.L5, U1.R5
+5V_SERVO: C1.1, C2.1, C3.1, C4.1, C5.1, C6.1, C7.1, C8.1, C9.1, C10.1, C11.1, C12.1, C13.1, C14.1, J2.1, J2.2, J3.1, J3.2, J4.1, J4.2, J5.1, J5.2, J6.1, J6.2, J7.1, J7.2, J8.1, J8.2, J9.1, J9.2, J10.1, J11.1, U1.L6, U1.R6, U1.V0, U1.V1, U1.V2, U1.V3, U1.V4, U1.V5, U1.V6, U1.V7, U1.V8, U1.V9, U1.V10, U1.V11, U1.V12, U1.V13, U1.V14, U1.V15
GND: C1.2, C2.2, C3.2, C4.2, C5.2, C6.2, C7.2, C8.2, C9.2, C10.2, C11.2, C12.2, C13.2, C14.2, J1.1, J1.2, J2.3, J2.4, J3.3, J3.4, J4.3, J4.4, J5.3, J5.4, J6.3, J6.4, J7.3, J7.4, J8.3, J8.4, J9.3, J9.4, J10.2, J11.2, U1.G0, U1.G1, U1.G2, U1.G3, U1.G4, U1.G5, U1.G6, U1.G7, U1.G8, U1.G9, U1.G10, U1.G11, U1.G12, U1.G13, U1.G14, U1.G15, U1.L1, U1.R1
I2C_SCL: J1.5, U1.L3, U1.R3
I2C_SDA: J1.4, U1.L4, U1.R4
LED_IN1: J2.7, JP1.3
LED_IN2: J3.7, JP1.2, JP2.3
LED_IN3: J4.7, JP2.2, JP3.3
LED_IN4: J5.7, JP3.2, JP4.3
LED_IN5: J6.7, JP4.2, JP5.3
LED_IN6: J7.7, JP5.2, JP6.3
LED_IN7: J8.7, JP6.2, JP7.3
LED_IN8: J9.7, JP7.2
LED_OUT1: J2.8, JP1.1
LED_OUT2: J3.8, JP2.1
LED_OUT3: J4.8, JP3.1
LED_OUT4: J5.8, JP4.1
LED_OUT5: J6.8, JP5.1
LED_OUT6: J7.8, JP6.1
LED_OUT7: J8.8, JP7.1
PCA_OE_N: J1.7, U1.L2, U1.R2
PWM0: J2.5, U1.S0
PWM1: J2.6, U1.S1
PWM2: J3.5, U1.S2
PWM3: J3.6, U1.S3
PWM4: J4.5, U1.S4
PWM5: J4.6, U1.S5
PWM6: J5.5, U1.S6
PWM7: J5.6, U1.S7
PWM8: J6.5, U1.S8
PWM9: J6.6, U1.S9
PWM10: J7.5, U1.S10
PWM11: J7.6, U1.S11
PWM12: J8.5, U1.S12
PWM13: J8.6, U1.S13
PWM14: J9.5, U1.S14
PWM15: J9.6, U1.S15
