MrScottFletcher/project-derek/derek-mcu/derek-mcu.ino

#include <Arduino.h>
#include <WiFi.h>
#include <WiFiUdp.h>
#include <Wire.h>
#include <esp_now.h>
#include <Preferences.h>

#ifndef ARDUINO_ARCH_ESP32
#error "This sketch targets ESP32-class boards."
#endif

namespace {

constexpr bool kEnableSerialLogs = true;
// Keep the serial monitor quiet during normal operation.  The `list`,
// `artnet`, `radio`, and `showstate` console commands always print on demand.
constexpr bool kEnablePeriodicSerialStatus = false;
constexpr uint8_t kSoftwareVersionMajor = 1;
constexpr uint8_t kSoftwareVersionMinor = 5;
constexpr uint8_t kSoftwareVersionRevision = 3;
constexpr uint8_t kProtocolVersion = 1;
constexpr uint16_t kProtocolMagic = 0xD311;
constexpr uint8_t kMaxClusters = 15;
constexpr uint8_t kMaxDerricks = 8;
constexpr uint8_t kBroadcastClusterId = 0xFF;
constexpr uint32_t kDiscoveryIntervalMs = 2000;
// ESP-NOW only has a small transmit queue.  During a QLC+ fade many clusters
// become dirty together, so serialize sends instead of filling that queue and
// silently losing the tail of a large update.
constexpr uint32_t kCommandIntervalMs = 5;
constexpr uint32_t kCommandHeartbeatMs = 750;
// Art-Net frames can arrive faster than the ESP-NOW scheduler can safely send
// them. Keep only the newest target and transmit it at a regular cadence,
// rather than waiting for a quiet period that would turn fades into snaps.
constexpr uint32_t kOutputFrameIntervalMs = 20;
constexpr uint32_t kStatusPageIntervalMs = 1000;
constexpr uint32_t kClusterOfflineMs = 3000;
constexpr uint32_t kBootDerekTestWaitMs = 5000;
constexpr uint32_t kBootDerekTestStepMs = 1200;
constexpr uint32_t kBootMassTestDiscoveryWaitMs = 5000;
constexpr uint32_t kBootMassTestAllUpHoldMs = 5000;
constexpr uint16_t kArtNetListenPort = 6454;
constexpr uint16_t kQlcOscPort = 7700;
const IPAddress kDefaultQlcOscHost(192, 168, 1, 149);
constexpr uint32_t kPirOscReleaseDelayMs = 75;
constexpr size_t kArtNetPacketBufferSize = 600;
constexpr uint8_t kMaxArtNetPacketsPerLoop = 16;
constexpr bool kEnableRadioDebugLogs = true;
constexpr uint32_t kRadioDebugLogIntervalMs = 1000;
constexpr uint8_t kClusterControllerChannels = 14;
constexpr uint8_t kChannelsPerDerek = 11;
constexpr uint8_t kDerekChannelsStart = kClusterControllerChannels + 1;
constexpr uint16_t kDerekOutputChannels = kMaxDerricks * kChannelsPerDerek;
constexpr uint16_t kChannelsPerCluster = kClusterControllerChannels + kDerekOutputChannels;
constexpr uint16_t kControllerActiveDerricksChannel = 1;
constexpr uint16_t kControllerApplyOutputsChannel = 2;
constexpr uint16_t kControllerEmergencyHideChannel = 3;
constexpr uint16_t kControllerRequestStatusChannel = 4;
constexpr uint16_t kControllerDiscoveryChannel = 5;
constexpr uint16_t kControllerAudioATrackMsbChannel = 6;
constexpr uint16_t kControllerAudioATrackLsbChannel = 7;
constexpr uint16_t kControllerAudioATriggerChannel = 8;
constexpr uint16_t kControllerAudioBTrackMsbChannel = 9;
constexpr uint16_t kControllerAudioBTrackLsbChannel = 10;
constexpr uint16_t kControllerAudioBTriggerChannel = 11;
constexpr uint16_t kControllerMovementSpeedChannel = 12;
constexpr uint16_t kControllerPirCenterChannel = 13;
constexpr uint16_t kControllerPirRightChannel = 14;
constexpr int8_t kI2cSdaPin = 8;
constexpr int8_t kI2cSclPin = 9;
constexpr uint8_t kOledAddress = 0x3C;
constexpr int8_t kTestModeSwitchPin = 4;
constexpr int8_t kTestAllUpButtonPin = 5;
constexpr int8_t kTestAllDownButtonPin = 6;
constexpr uint32_t kTestButtonDebounceMs = 35;
// RX480E-4 receiver inputs. Power the receiver from the MCU's 3.3 V rail so
// its D0-D3 CMOS outputs are always safe for ESP32-S3 GPIO. The receiver must
// be paired in momentary mode: a rising edge is one QLC+ show request.
// The installed fob labels run opposite the receiver's D0-D3 output order.
constexpr int8_t kRemoteButtonAPin = 18;  // RX480E D3
constexpr int8_t kRemoteButtonBPin = 17;  // RX480E D2
constexpr int8_t kRemoteButtonCPin = 16;  // RX480E D1
constexpr int8_t kRemoteButtonDPin = 15;  // RX480E D0
constexpr uint8_t kRemoteButtonCount = 4;
constexpr int8_t kRemoteButtonPins[kRemoteButtonCount] = {
    kRemoteButtonAPin, kRemoteButtonBPin, kRemoteButtonCPin, kRemoteButtonDPin};
constexpr char kRemoteButtonNames[kRemoteButtonCount] = {'A', 'B', 'C', 'D'};
constexpr uint32_t kRemoteButtonDebounceMs = 125;
constexpr uint32_t kRemoteOscReleaseDelayMs = 75;
constexpr uint8_t kDerekLiftMinimum = 0;
constexpr uint8_t kDerekLiftMaximum = 170;
constexpr uint8_t kBroadcastMac[6] = {0xFF, 0xFF, 0xFF, 0xFF, 0xFF, 0xFF};

// Fill these in for the router/network used by the QLC+ computer.
// ESP-NOW peers must share the same Wi-Fi radio channel as this connection.
constexpr char kWifiSsid[] = "DerekWifi";
constexpr char kWifiPassword[] = "derekderek";

// MCU OLED: Hosyond 2.42-inch 128x64 I2C module with an SSD1309 controller.
// Wiring on this board: GND, VCC, SCL -> GPIO9, SDA/SCA -> GPIO8.
// Test inputs use internal pull-ups: wire each switch/button from its GPIO to GND.
// GPIO4: test-mode switch; GPIO5: All Up button; GPIO6: All Down button.
constexpr int8_t kButtonNextPin = -1;
constexpr int8_t kButtonPrevPin = -1;

enum MessageKind : uint8_t {
  kMessageRegister = 1,
  kMessageCommand = 2,
  kMessageStatus = 3,
};

enum CommandFlags : uint8_t {
  kCommandFlagApplyOutputs = 1 << 0,
  kCommandFlagAudioA = 1 << 1,
  kCommandFlagAudioB = 1 << 2,
  kCommandFlagRequestStatus = 1 << 3,
  kCommandFlagEmergencyHide = 1 << 4,
  kCommandFlagDiscovery = 1 << 5,
};

enum BootDerekTestPhase : uint8_t {
  kBootDerekTestLift = 0,
  kBootDerekTestLeft = 1,
  kBootDerekTestRight = 2,
  kBootDerekTestCenter = 3,
  kBootDerekTestLower = 4,
  kBootDerekTestPhaseCount = 5,
};

enum BootMassTestPhase : uint8_t {
  kBootMassTestWaitingForClusters = 0,
  kBootMassTestAllUp = 1,
  kBootMassTestDone = 2,
};

enum MovementSpeed : uint8_t {
  kMovementSpeedFast = 0,
  kMovementSpeedMedium = 1,
  kMovementSpeedSlow = 2,
};

enum TestLiftState : uint8_t {
  kTestLiftAllDown = 0,
  kTestLiftAllUp = 1,
};

struct RgbColor {
  uint8_t r;
  uint8_t g;
  uint8_t b;
};

struct DerekCommand {
  uint8_t pan;
  uint8_t lift;
  // RGB controls map to the physical LED-chain order: spotlight (two pixels),
  // right eye (one pixel), then left eye (one pixel).
  RgbColor spotlightColor;
  RgbColor rightEyeColor;
  RgbColor leftEyeColor;
};

#pragma pack(push, 1)
struct ClusterCommandPacket {
  uint16_t magic;
  uint8_t version;
  uint8_t kind;
  uint8_t clusterId;
  uint16_t sequence;
  uint8_t flags;
  uint8_t activeDerricks;
  uint8_t movementSpeed;
  uint16_t audioTrackA;
  uint16_t audioTrackB;
  DerekCommand derricks[kMaxDerricks];
};

struct ClusterStatusPacket {
  uint16_t magic;
  uint8_t version;
  uint8_t kind;
  uint8_t clusterId;
  uint16_t sequence;
  uint8_t activeDerricks;
  uint8_t pirStateBits;
  uint16_t healthFlags;
  uint32_t uptimeMs;
  uint32_t lastCommandAgeMs;
};
#pragma pack(pop)

struct ClusterRuntime {
  bool occupied;
  bool online;
  uint8_t clusterId;
  uint8_t mac[6];
  uint16_t lastSequence;
  uint8_t lastActiveDerricks;
  uint8_t lastPirBits;
  uint16_t lastHealthFlags;
  uint32_t lastSeenAtMs;
  uint32_t lastStatusUptimeMs;
  uint16_t audioTrackASetting;
  uint16_t audioTrackBSetting;
  uint32_t lastCommandSentAtMs;
  bool audioATriggerHigh;
  bool audioBTriggerHigh;
  bool commandDirty;
  MovementSpeed movementSpeed;
  ClusterCommandPacket desiredCommand;
};

struct PendingPirOscRelease {
  bool active;
  uint8_t clusterId;
  uint8_t sensorBit;
  uint32_t dueAtMs;
};

struct PendingRemoteOscRelease {
  bool active;
  uint8_t buttonIndex;
  uint32_t dueAtMs;
};

ClusterRuntime gClusters[kMaxClusters];
uint32_t gLastDiscoveryAtMs = 0;
uint32_t gLastCommandAtMs = 0;
uint32_t gLastStatusPageAtMs = 0;
uint32_t gBootStartedAtMs = 0;
uint32_t gLastBootDerekTestStepAtMs = 0;
uint32_t gBootMassTestPhaseStartedAtMs = 0;
uint16_t gSequenceCounter = 1;
uint8_t gCurrentPage = 0;
uint8_t gBootDerekTestClusterCursor = 0;
uint8_t gBootDerekTestDerekCursor = 0;
BootDerekTestPhase gBootDerekTestPhase = kBootDerekTestLift;
bool gBootDerekTestRunning = false;
bool gBootDerekTestDone = false;
BootMassTestPhase gBootMassTestPhase = kBootMassTestWaitingForClusters;
bool gOledReady = false;
bool gTestModeEnabled = false;
bool gTestAllUpButtonWasPressed = false;
bool gTestAllDownButtonWasPressed = false;
uint32_t gTestLastButtonEventAtMs = 0;
TestLiftState gTestLiftState = kTestLiftAllDown;
bool gRemoteButtonWasPressed[kRemoteButtonCount] = {};
uint32_t gRemoteLastButtonEventAtMs[kRemoteButtonCount] = {};
int8_t gLastRemoteButtonIndex = -1;
WiFiUDP gArtNetUdp;
WiFiUDP gQlcOscUdp;
IPAddress gQlcOscHost = kDefaultQlcOscHost;
Preferences gMcuPreferences;
PendingPirOscRelease gPendingPirOscReleases[kMaxClusters * 3] = {};
PendingRemoteOscRelease gPendingRemoteOscReleases[kRemoteButtonCount] = {};
uint8_t gArtNetDmx[kMaxClusters][kChannelsPerCluster] = {};
bool gArtNetUniverseSeen[kMaxClusters] = {};
uint32_t gArtNetPacketsReceived = 0;
uint32_t gArtNetFramesAccepted = 0;
uint32_t gArtNetFramesRejected = 0;
uint32_t gLastArtNetFrameAtMs = 0;
bool gLastArtNetCommandValid = false;
uint8_t gLastArtNetCommandClusterId = 0;
uint16_t gLastArtNetCommandChannel = 0;
uint8_t gLastArtNetCommandValue = 0;
uint32_t gEspNowPacketsQueued = 0;
uint32_t gEspNowQueueFailures = 0;
uint32_t gEspNowSendSuccesses = 0;
uint32_t gEspNowSendFailures = 0;
uint32_t gLastEspNowQueuedAtMs = 0;
uint32_t gLastEspNowCallbackAtMs = 0;
uint32_t gLastRadioDebugLogAtMs = 0;
volatile bool gEspNowSendInFlight = false;
volatile int8_t gEspNowInFlightClusterIndex = -1;
volatile int8_t gEspNowFailedClusterIndex = -1;
uint8_t gNextCommandClusterIndex = 0;
uint8_t gLastEspNowClusterId = 0;
uint16_t gLastEspNowSequence = 0;
uint8_t gLastEspNowFlags = 0;
int gLastEspNowQueueResult = 0;
int gLastEspNowSendStatus = 0;
bool gClusterIdConflictDetected = false;
uint8_t gConflictClusterId = 0;
char gConflictExistingMac[18] = {};
char gConflictNewMac[18] = {};

int8_t findClusterIndexById(uint8_t clusterId);
void applyCachedArtNetUniverse(uint8_t clusterId);

bool addEspNowPeer(const uint8_t* macAddress) {
  if (esp_now_is_peer_exist(macAddress)) {
    return true;
  }

  esp_now_peer_info_t peerInfo = {};
  memcpy(peerInfo.peer_addr, macAddress, 6);
  peerInfo.channel = 0;
  peerInfo.encrypt = false;
  return esp_now_add_peer(&peerInfo) == ESP_OK;
}

void formatMac(const uint8_t* mac, char* buffer, size_t bufferLen) {
  snprintf(
      buffer,
      bufferLen,
      "%02X:%02X:%02X:%02X:%02X:%02X",
      mac[0],
      mac[1],
      mac[2],
      mac[3],
      mac[4],
      mac[5]);
}

void formatIpAddress(const IPAddress& ip, char* buffer, size_t bufferLen) {
  snprintf(buffer, bufferLen, "%u.%u.%u.%u", ip[0], ip[1], ip[2], ip[3]);
}

bool parseIpAddress(const char* text, IPAddress& ip) {
  unsigned int octets[4] = {};
  char trailing = '\0';
  if (text == nullptr || sscanf(text, "%u.%u.%u.%u%c", &octets[0], &octets[1], &octets[2], &octets[3], &trailing) != 4) {
    return false;
  }

  for (uint8_t i = 0; i < 4; ++i) {
    if (octets[i] > 255) {
      return false;
    }
  }

  ip = IPAddress(octets[0], octets[1], octets[2], octets[3]);
  return true;
}

void loadQlcOscConfiguration() {
  gMcuPreferences.begin("derek-mcu", false);

  char hostText[16] = {};
  const size_t hostLength = gMcuPreferences.getString("qlcOscHost", hostText, sizeof(hostText));
  IPAddress configuredHost;
  if (hostLength > 0 && parseIpAddress(hostText, configuredHost)) {
    gQlcOscHost = configuredHost;
  } else {
    gQlcOscHost = kDefaultQlcOscHost;
    char defaultHostText[16] = {};
    formatIpAddress(gQlcOscHost, defaultHostText, sizeof(defaultHostText));
    gMcuPreferences.putString("qlcOscHost", defaultHostText);
  }
}

bool writeOscString(const char* value) {
  if (value == nullptr) {
    return false;
  }

  const size_t valueLength = strlen(value) + 1;
  if (gQlcOscUdp.write(reinterpret_cast<const uint8_t*>(value), valueLength) != valueLength) {
    return false;
  }

  const uint8_t padding[3] = {0, 0, 0};
  const size_t paddingLength = (4 - (valueLength % 4)) % 4;
  return paddingLength == 0 || gQlcOscUdp.write(padding, paddingLength) == paddingLength;
}

bool sendQlcOscFloatEvent(const char* address, bool active) {
  if (WiFi.status() != WL_CONNECTED || address == nullptr) {
    return false;
  }

  if (!gQlcOscUdp.beginPacket(gQlcOscHost, kQlcOscPort)) {
    return false;
  }

  const uint8_t value[] = {0x3F, 0x80, 0x00, 0x00};  // OSC float32 1.0
  const uint8_t zero[] = {0x00, 0x00, 0x00, 0x00};
  const bool wrote = writeOscString(address) && writeOscString(",f") &&
                     gQlcOscUdp.write(active ? value : zero, sizeof(value)) == sizeof(value);
  if (!wrote) {
    gQlcOscUdp.endPacket();
    return false;
  }

  return gQlcOscUdp.endPacket() == 1;
}

bool sendQlcOscPirEvent(uint8_t clusterId, const char* direction, bool active) {
  if (direction == nullptr || clusterId >= kMaxClusters) {
    return false;
  }

  char address[36] = {};
  snprintf(address, sizeof(address), "/derek/pir/%u/%s", clusterId, direction);
  return sendQlcOscFloatEvent(address, active);
}

bool sendQlcOscRemoteEvent(uint8_t buttonIndex, bool active) {
  if (buttonIndex >= kRemoteButtonCount) {
    return false;
  }

  char address[20] = {};
  snprintf(address, sizeof(address), "/derek/remote/%c", kRemoteButtonNames[buttonIndex]);
  return sendQlcOscFloatEvent(address, active);
}

const char* pirDirectionName(uint8_t sensorBit) {
  static constexpr const char* kDirectionNames[] = {"left", "center", "right"};
  return sensorBit < 3 ? kDirectionNames[sensorBit] : nullptr;
}

void queuePirOscRelease(uint8_t clusterId, uint8_t sensorBit, uint32_t nowMs) {
  for (PendingPirOscRelease& pending : gPendingPirOscReleases) {
    if (!pending.active) {
      pending = {true, clusterId, sensorBit, nowMs + kPirOscReleaseDelayMs};
      return;
    }
  }

  Serial.println("PIR OSC release queue full.");
}

void publishPirRisingEdges(uint8_t clusterId, uint8_t priorPirBits, uint8_t newPirBits, uint32_t nowMs) {
  const uint8_t risingBits = static_cast<uint8_t>((~priorPirBits) & newPirBits & 0x07);
  for (uint8_t sensorBit = 0; sensorBit < 3; ++sensorBit) {
    if ((risingBits & (1 << sensorBit)) == 0) {
      continue;
    }

    const char* direction = pirDirectionName(sensorBit);
    if (sendQlcOscPirEvent(clusterId, direction, true)) {
      queuePirOscRelease(clusterId, sensorBit, nowMs);
    } else {
      Serial.print("PIR OSC send failed for cluster ");
      Serial.println(clusterId);
    }
  }
}

void servicePendingPirOscReleases(uint32_t nowMs) {
  for (PendingPirOscRelease& pending : gPendingPirOscReleases) {
    if (!pending.active || static_cast<int32_t>(nowMs - pending.dueAtMs) < 0) {
      continue;
    }

    const char* direction = pirDirectionName(pending.sensorBit);
    sendQlcOscPirEvent(pending.clusterId, direction, false);
    pending.active = false;
  }
}

void queueRemoteOscRelease(uint8_t buttonIndex, uint32_t nowMs) {
  if (buttonIndex >= kRemoteButtonCount) {
    return;
  }

  gPendingRemoteOscReleases[buttonIndex] = {
      true, buttonIndex, nowMs + kRemoteOscReleaseDelayMs};
}

void servicePendingRemoteOscReleases(uint32_t nowMs) {
  for (PendingRemoteOscRelease& pending : gPendingRemoteOscReleases) {
    if (!pending.active || static_cast<int32_t>(nowMs - pending.dueAtMs) < 0) {
      continue;
    }

    sendQlcOscRemoteEvent(pending.buttonIndex, false);
    pending.active = false;
  }
}

bool isProtocolPacketValid(const uint8_t* data, size_t len) {
  if (len < sizeof(uint16_t) + sizeof(uint8_t) + sizeof(uint8_t)) {
    return false;
  }

  const uint16_t magic = static_cast<uint16_t>(data[0]) | (static_cast<uint16_t>(data[1]) << 8);
  return magic == kProtocolMagic && data[2] == kProtocolVersion;
}

bool writeI2cBytes(uint8_t address, const uint8_t* data, size_t len) {
  Wire.beginTransmission(address);
  Wire.write(data, len);
  return Wire.endTransmission() == 0;
}

void sendOledCommand(uint8_t command) {
  const uint8_t data[2] = {0x00, command};
  writeI2cBytes(kOledAddress, data, sizeof(data));
}

void sendOledData(const uint8_t* data, size_t len) {
  size_t offset = 0;
  while (offset < len) {
    const size_t chunkLen = min<size_t>(len - offset, 15);
    Wire.beginTransmission(kOledAddress);
    Wire.write(0x40);
    Wire.write(data + offset, chunkLen);
    Wire.endTransmission();
    offset += chunkLen;
  }
}

bool initializeOled() {
  // SSD1309 initialization for a 128x64, internally powered I2C panel.  This
  // differs from the old SSD1306 sequence in its DC-DC control command.
  const uint8_t initCommands[] = {
      0xAE, 0xD5, 0x80, 0xA8, 0x3F, 0xD3, 0x00, 0x40, 0xAD, 0x8B, 0x20, 0x00,
      0xA1, 0xC8, 0xDA, 0x12, 0x81, 0x7F, 0xD9, 0x22, 0xDB, 0x34, 0xA4, 0xA6,
      0x2E, 0xAF,
  };

  Wire.beginTransmission(kOledAddress);
  if (Wire.endTransmission() != 0) {
    return false;
  }

  for (uint8_t command : initCommands) {
    sendOledCommand(command);
  }
  return true;
}

uint8_t fontColumn(char character, uint8_t column) {
  static const uint8_t kDigits[10][5] = {
      {0x3E, 0x51, 0x49, 0x45, 0x3E}, {0x00, 0x42, 0x7F, 0x40, 0x00},
      {0x42, 0x61, 0x51, 0x49, 0x46}, {0x21, 0x41, 0x45, 0x4B, 0x31},
      {0x18, 0x14, 0x12, 0x7F, 0x10}, {0x27, 0x45, 0x45, 0x45, 0x39},
      {0x3C, 0x4A, 0x49, 0x49, 0x30}, {0x01, 0x71, 0x09, 0x05, 0x03},
      {0x36, 0x49, 0x49, 0x49, 0x36}, {0x06, 0x49, 0x49, 0x29, 0x1E},
  };

  static const uint8_t kLetters[26][5] = {
      {0x7E, 0x11, 0x11, 0x11, 0x7E}, {0x7F, 0x49, 0x49, 0x49, 0x36},
      {0x3E, 0x41, 0x41, 0x41, 0x22}, {0x7F, 0x41, 0x41, 0x22, 0x1C},
      {0x7F, 0x49, 0x49, 0x49, 0x41}, {0x7F, 0x09, 0x09, 0x09, 0x01},
      {0x3E, 0x41, 0x49, 0x49, 0x7A}, {0x7F, 0x08, 0x08, 0x08, 0x7F},
      {0x00, 0x41, 0x7F, 0x41, 0x00}, {0x20, 0x40, 0x41, 0x3F, 0x01},
      {0x7F, 0x08, 0x14, 0x22, 0x41}, {0x7F, 0x40, 0x40, 0x40, 0x40},
      {0x7F, 0x02, 0x0C, 0x02, 0x7F}, {0x7F, 0x04, 0x08, 0x10, 0x7F},
      {0x3E, 0x41, 0x41, 0x41, 0x3E}, {0x7F, 0x09, 0x09, 0x09, 0x06},
      {0x3E, 0x41, 0x51, 0x21, 0x5E}, {0x7F, 0x09, 0x19, 0x29, 0x46},
      {0x46, 0x49, 0x49, 0x49, 0x31}, {0x01, 0x01, 0x7F, 0x01, 0x01},
      {0x3F, 0x40, 0x40, 0x40, 0x3F}, {0x1F, 0x20, 0x40, 0x20, 0x1F},
      {0x3F, 0x40, 0x38, 0x40, 0x3F}, {0x63, 0x14, 0x08, 0x14, 0x63},
      {0x07, 0x08, 0x70, 0x08, 0x07}, {0x61, 0x51, 0x49, 0x45, 0x43},
  };

  if (column >= 5) {
    return 0x00;
  }
  if (character >= 'a' && character <= 'z') {
    character -= 32;
  }
  if (character >= '0' && character <= '9') {
    return kDigits[character - '0'][column];
  }
  if (character >= 'A' && character <= 'Z') {
    return kLetters[character - 'A'][column];
  }

  switch (character) {
    case ':':
      return column == 2 ? 0x36 : 0x00;
    case '.':
      return column == 2 ? 0x40 : 0x00;
    case '/':
      return 0x40 >> column;
    case '-':
      return column > 0 && column < 4 ? 0x08 : 0x00;
    case '_':
      return 0x40;
    case ' ':
    default:
      return 0x00;
  }
}

void writeOledLine(uint8_t page, const char* text) {
  uint8_t pageData[128] = {};
  uint8_t cursor = 0;

  for (uint8_t i = 0; text[i] != '\0' && cursor < sizeof(pageData); ++i) {
    for (uint8_t col = 0; col < 5 && cursor < sizeof(pageData); ++col) {
      pageData[cursor++] = fontColumn(text[i], col);
    }
    if (cursor < sizeof(pageData)) {
      pageData[cursor++] = 0x00;
    }
  }

  sendOledCommand(0xB0 + page);
  sendOledCommand(0x00);
  sendOledCommand(0x10);
  sendOledData(pageData, sizeof(pageData));
}

void clearOled() {
  for (uint8_t page = 0; page < 8; ++page) {
    writeOledLine(page, "");
  }
}

void writeOledClusterIdConflict() {
  if (!gOledReady) {
    return;
  }

  char line[22] = {};
  writeOledLine(0, "DIP CONFLICT");
  snprintf(line, sizeof(line), "UNIVERSE %u DUP", gConflictClusterId);
  writeOledLine(1, line);
  writeOledLine(2, "KEEPING EXISTING");
  writeOledLine(3, gConflictExistingMac);
  writeOledLine(4, "IGNORING NEW");
  writeOledLine(5, gConflictNewMac);
  writeOledLine(6, "CHECK DIP SWITCHES");
  writeOledLine(7, "REBOOT AFTER FIX");
}

uint8_t countRegisteredClusters() {
  uint8_t count = 0;
  for (uint8_t i = 0; i < kMaxClusters; ++i) {
    if (gClusters[i].occupied) {
      ++count;
    }
  }
  return count;
}

uint8_t countOnlineClusters() {
  uint8_t count = 0;
  for (uint8_t i = 0; i < kMaxClusters; ++i) {
    if (gClusters[i].occupied && gClusters[i].online) {
      ++count;
    }
  }
  return count;
}

const char* bootDerekTestPhaseName() {
  switch (gBootDerekTestPhase) {
    case kBootDerekTestLift:
      return "LIFT";
    case kBootDerekTestLeft:
      return "LEFT";
    case kBootDerekTestRight:
      return "RIGHT";
    case kBootDerekTestCenter:
      return "CENTER";
    case kBootDerekTestLower:
      return "LOWER";
    default:
      return "DONE";
  }
}

void writeOledStatusPage(uint32_t nowMs) {
  if (!gOledReady) {
    return;
  }

  if (gClusterIdConflictDetected) {
    writeOledClusterIdConflict();
    return;
  }

  char line[22] = {};
  snprintf(
      line,
      sizeof(line),
      "MCU V%u.%u.%u S%u",
      kSoftwareVersionMajor,
      kSoftwareVersionMinor,
      kSoftwareVersionRevision,
      static_cast<unsigned>(gCurrentPage));
  writeOledLine(0, line);

  snprintf(line, sizeof(line), "NODES %u ONLINE %u", countRegisteredClusters(), countOnlineClusters());
  writeOledLine(1, line);

  if (WiFi.status() == WL_CONNECTED) {
    char ipBuffer[16] = {};
    formatIpAddress(WiFi.localIP(), ipBuffer, sizeof(ipBuffer));
    snprintf(line, sizeof(line), "IP %s", ipBuffer);
  } else {
    snprintf(line, sizeof(line), "WIFI OFF CH %u", WiFi.channel());
  }
  writeOledLine(2, line);

  if (gLastRemoteButtonIndex >= 0) {
    snprintf(line, sizeof(line), "REMOTE %c PRESSED", kRemoteButtonNames[gLastRemoteButtonIndex]);
  } else {
    switch (gBootMassTestPhase) {
      case kBootMassTestWaitingForClusters:
        snprintf(line, sizeof(line), "TEST WAIT NODES");
        break;
      case kBootMassTestAllUp:
        snprintf(line, sizeof(line), "TEST ALL UP 5 SEC");
        break;
      case kBootMassTestDone:
      default:
        snprintf(line, sizeof(line), "TEST DONE");
        break;
    }
  }
  writeOledLine(3, line);

  if (gLastArtNetCommandValid) {
    snprintf(
        line,
        sizeof(line),
        "ART U%u CH%u V%u",
        gLastArtNetCommandClusterId,
        gLastArtNetCommandChannel,
        gLastArtNetCommandValue);
  } else if (gArtNetFramesAccepted > 0) {
    snprintf(line, sizeof(line), "ARTNET RX%lu", static_cast<unsigned long>(gArtNetFramesAccepted));
  } else if (gArtNetPacketsReceived > 0) {
    snprintf(line, sizeof(line), "ARTNET REJECT %lu", static_cast<unsigned long>(gArtNetFramesRejected));
  } else {
    snprintf(line, sizeof(line), "ARTNET WAIT %u", kArtNetListenPort);
  }
  writeOledLine(4, line);

  for (uint8_t lineIndex = 0; lineIndex < 3; ++lineIndex) {
    const uint8_t clusterIndex = lineIndex;
    if (clusterIndex < kMaxClusters && gClusters[clusterIndex].occupied) {
      snprintf(
          line,
          sizeof(line),
          "C%u D%u %s P%u",
          gClusters[clusterIndex].clusterId,
          gClusters[clusterIndex].lastActiveDerricks,
          gClusters[clusterIndex].online ? "ON" : "OFF",
          gClusters[clusterIndex].lastPirBits);
    } else {
      snprintf(line, sizeof(line), "C- WAITING");
    }
    writeOledLine(5 + lineIndex, line);
  }
}

void writeOledTestModePage() {
  if (!gOledReady) {
    return;
  }

  char line[22] = {};
  writeOledLine(0, "MCU TEST MODE");
  writeOledLine(1, gTestLiftState == kTestLiftAllUp ? "INTENDED ALL UP" : "INTENDED ALL DOWN");
  writeOledLine(2, "GPIO5 ALL UP");
  writeOledLine(3, "GPIO6 ALL DOWN");
  snprintf(line, sizeof(line), "NODES %u ONLINE %u", countRegisteredClusters(), countOnlineClusters());
  writeOledLine(4, line);
  writeOledLine(5, "ARTNET INPUT PAUSED");
  writeOledLine(6, "ESP-NOW ACTIVE");
  writeOledLine(7, "SWITCH GPIO4 ON");
}

uint8_t dmxToPan(uint8_t value) {
  return map(value, 0, 255, 10, 170);
}

uint8_t dmxToLift(uint8_t value) {
  return map(value, 0, 255, 0, 170);
}

MovementSpeed dmxToMovementSpeed(uint8_t value) {
  if (value < 85) {
    return kMovementSpeedFast;
  }
  if (value < 170) {
    return kMovementSpeedMedium;
  }
  return kMovementSpeedSlow;
}

bool parseMovementSpeedName(const char* speedName, MovementSpeed& movementSpeed) {
  if (strcmp(speedName, "fast") == 0 || strcmp(speedName, "Fast") == 0) {
    movementSpeed = kMovementSpeedFast;
    return true;
  }
  if (strcmp(speedName, "medium") == 0 || strcmp(speedName, "Medium") == 0) {
    movementSpeed = kMovementSpeedMedium;
    return true;
  }
  if (strcmp(speedName, "slow") == 0 || strcmp(speedName, "Slow") == 0) {
    movementSpeed = kMovementSpeedSlow;
    return true;
  }
  return false;
}

void initializeDefaultCommand(ClusterCommandPacket& command, uint8_t clusterId) {
  memset(&command, 0, sizeof(command));
  command.magic = kProtocolMagic;
  command.version = kProtocolVersion;
  command.kind = kMessageCommand;
  command.clusterId = clusterId;
  command.activeDerricks = kMaxDerricks;
  command.movementSpeed = kMovementSpeedFast;
  command.flags = kCommandFlagApplyOutputs;

  for (uint8_t i = 0; i < kMaxDerricks; ++i) {
    command.derricks[i].pan = 90;
    command.derricks[i].lift = 0;
  }
}

void setAudioTrackByte(uint16_t& track, bool highByte, uint8_t value) {
  if (highByte) {
    track = static_cast<uint16_t>((track & 0x00FF) | (static_cast<uint16_t>(value) << 8));
  } else {
    track = static_cast<uint16_t>((track & 0xFF00) | value);
  }
}

void triggerAudioTrack(ClusterRuntime& cluster, bool playerA) {
  ClusterCommandPacket& packet = cluster.desiredCommand;
  const uint16_t track = playerA ? cluster.audioTrackASetting : cluster.audioTrackBSetting;
  if (track == 0) {
    return;
  }

  if (playerA) {
    packet.audioTrackA = track;
    packet.flags |= kCommandFlagAudioA;
  } else {
    packet.audioTrackB = track;
    packet.flags |= kCommandFlagAudioB;
  }
  packet.flags |= kCommandFlagRequestStatus;
  cluster.commandDirty = true;
}

void applyClusterControllerChannel(ClusterRuntime& cluster, uint16_t channel, uint8_t value) {
  ClusterCommandPacket& packet = cluster.desiredCommand;
  const bool high = value >= 128;

  switch (channel) {
    case kControllerActiveDerricksChannel:
      packet.activeDerricks = value == 0 ? kMaxDerricks : min<uint8_t>(value, kMaxDerricks);
      packet.flags |= kCommandFlagRequestStatus;
      break;
    case kControllerApplyOutputsChannel:
      if (high) {
        packet.flags |= kCommandFlagApplyOutputs;
      }
      packet.flags |= kCommandFlagRequestStatus;
      break;
    case kControllerEmergencyHideChannel:
      if (high) {
        packet.flags |= kCommandFlagEmergencyHide | kCommandFlagRequestStatus;
      }
      break;
    case kControllerRequestStatusChannel:
      if (high) {
        packet.flags |= kCommandFlagRequestStatus;
      }
      break;
    case kControllerDiscoveryChannel:
      if (high) {
        packet.flags |= kCommandFlagDiscovery | kCommandFlagRequestStatus;
      }
      break;
    case kControllerAudioATrackMsbChannel:
      setAudioTrackByte(cluster.audioTrackASetting, true, value);
      break;
    case kControllerAudioATrackLsbChannel:
      setAudioTrackByte(cluster.audioTrackASetting, false, value);
      break;
    case kControllerAudioATriggerChannel:
      if (high && !cluster.audioATriggerHigh) {
        triggerAudioTrack(cluster, true);
      }
      cluster.audioATriggerHigh = high;
      break;
    case kControllerAudioBTrackMsbChannel:
      setAudioTrackByte(cluster.audioTrackBSetting, true, value);
      break;
    case kControllerAudioBTrackLsbChannel:
      setAudioTrackByte(cluster.audioTrackBSetting, false, value);
      break;
    case kControllerAudioBTriggerChannel:
      if (high && !cluster.audioBTriggerHigh) {
        triggerAudioTrack(cluster, false);
      }
      cluster.audioBTriggerHigh = high;
      break;
    case kControllerMovementSpeedChannel:
      cluster.movementSpeed = dmxToMovementSpeed(value);
      packet.movementSpeed = cluster.movementSpeed;
      packet.flags |= kCommandFlagRequestStatus;
      break;
    case kControllerPirCenterChannel:
    case kControllerPirRightChannel:
      // PIR channels are feedback/status placeholders in the QLC fixture.
      break;
  }
}

void applyDerekChannel(ClusterCommandPacket& packet, uint16_t channel, uint8_t value) {
  if (channel == 0) {
    return;
  }

  if (channel < kDerekChannelsStart || channel > kChannelsPerCluster) {
    return;
  }

  const uint16_t zeroBased = channel - kDerekChannelsStart;
  const uint8_t derekIndex = zeroBased / kChannelsPerDerek;
  const uint8_t channelOffset = zeroBased % kChannelsPerDerek;
  DerekCommand& derek = packet.derricks[derekIndex];
  packet.flags |= kCommandFlagApplyOutputs;

  switch (channelOffset) {
    case 0:
      derek.pan = dmxToPan(value);
      break;
    case 1:
      derek.lift = dmxToLift(value);
      break;
    case 2:
      derek.spotlightColor.r = value;
      break;
    case 3:
      derek.spotlightColor.g = value;
      break;
    case 4:
      derek.spotlightColor.b = value;
      break;
    case 5:
      derek.rightEyeColor.r = value;
      break;
    case 6:
      derek.rightEyeColor.g = value;
      break;
    case 7:
      derek.rightEyeColor.b = value;
      break;
    case 8:
      derek.leftEyeColor.r = value;
      break;
    case 9:
      derek.leftEyeColor.g = value;
      break;
    case 10:
      derek.leftEyeColor.b = value;
      break;
  }
}

void applyDmxChannelToCluster(ClusterRuntime& cluster, uint16_t channel, uint8_t value) {
  if (channel == 0 || channel > kChannelsPerCluster) {
    return;
  }

  cluster.commandDirty = true;

  if (channel <= kClusterControllerChannels) {
    applyClusterControllerChannel(cluster, channel, value);
    return;
  }

  applyDerekChannel(cluster.desiredCommand, channel, value);
}

void applyCachedArtNetUniverse(uint8_t clusterId) {
  if (clusterId >= kMaxClusters || !gArtNetUniverseSeen[clusterId]) {
    return;
  }

  const int8_t clusterIndex = findClusterIndexById(clusterId);
  if (clusterIndex < 0) {
    return;
  }

  ClusterRuntime& cluster = gClusters[clusterIndex];
  for (uint16_t channel = 1; channel <= kChannelsPerCluster; ++channel) {
    applyDmxChannelToCluster(cluster, channel, gArtNetDmx[clusterId][channel - 1]);
  }
}

int8_t findClusterIndexByMac(const uint8_t* macAddress) {
  for (uint8_t i = 0; i < kMaxClusters; ++i) {
    if (gClusters[i].occupied && memcmp(gClusters[i].mac, macAddress, 6) == 0) {
      return static_cast<int8_t>(i);
    }
  }
  return -1;
}

int8_t findClusterIndexById(uint8_t clusterId) {
  for (uint8_t i = 0; i < kMaxClusters; ++i) {
    if (gClusters[i].occupied && gClusters[i].clusterId == clusterId) {
      return static_cast<int8_t>(i);
    }
  }
  return -1;
}

void initializeClusterSlot(ClusterRuntime& cluster, const uint8_t* macAddress, uint8_t clusterId) {
  cluster.occupied = true;
  cluster.online = true;
  cluster.clusterId = clusterId;
  cluster.lastActiveDerricks = kMaxDerricks;
  cluster.movementSpeed = kMovementSpeedFast;
  memcpy(cluster.mac, macAddress, 6);
  initializeDefaultCommand(cluster.desiredCommand, clusterId);
  addEspNowPeer(macAddress);
}

void clearClusterSlot(ClusterRuntime& cluster) {
  memset(&cluster, 0, sizeof(cluster));
}

void printClusterIdConflict(uint8_t clusterId, const uint8_t* existingMac, const uint8_t* newMac) {
  gClusterIdConflictDetected = true;
  gConflictClusterId = clusterId;
  formatMac(existingMac, gConflictExistingMac, sizeof(gConflictExistingMac));
  formatMac(newMac, gConflictNewMac, sizeof(gConflictNewMac));
  writeOledClusterIdConflict();

  if (!kEnableSerialLogs) {
    return;
  }

  Serial.print("Cluster ID conflict: DIP/Universe ");
  Serial.print(clusterId);
  Serial.print(" already belongs to ");
  Serial.print(gConflictExistingMac);
  Serial.print("; ignoring ");
  Serial.println(gConflictNewMac);
}

int8_t reserveClusterSlot(const uint8_t* macAddress, uint8_t clusterId) {
  if (clusterId >= kMaxClusters) {
    return -1;
  }

  const uint8_t preferredIndex = clusterId;
  const int8_t existingByMac = findClusterIndexByMac(macAddress);
  ClusterRuntime& preferredSlot = gClusters[preferredIndex];

  if (existingByMac == preferredIndex) {
    return existingByMac;
  }

  if (preferredSlot.occupied && memcmp(preferredSlot.mac, macAddress, 6) != 0) {
    printClusterIdConflict(clusterId, preferredSlot.mac, macAddress);
    return -1;
  }

  if (existingByMac >= 0) {
    ClusterRuntime movedCluster = gClusters[existingByMac];
    clearClusterSlot(gClusters[existingByMac]);
    gClusters[preferredIndex] = movedCluster;
    gClusters[preferredIndex].clusterId = clusterId;
    gClusters[preferredIndex].desiredCommand.clusterId = clusterId;
    return static_cast<int8_t>(preferredIndex);
  }

  initializeClusterSlot(preferredSlot, macAddress, clusterId);
  return static_cast<int8_t>(preferredIndex);
}

int8_t findNextOnlineClusterIndex(uint8_t startIndex) {
  for (uint8_t i = startIndex; i < kMaxClusters; ++i) {
    const uint8_t expectedClusterId = i;
    if (gClusters[i].occupied && gClusters[i].online && gClusters[i].clusterId == expectedClusterId &&
        gClusters[i].lastActiveDerricks > 0) {
      return static_cast<int8_t>(i);
    }
  }
  return -1;
}

void updateClusterFromStatus(const uint8_t* macAddress, const ClusterStatusPacket& status, uint32_t nowMs) {
  int8_t clusterIndex = reserveClusterSlot(macAddress, status.clusterId);
  if (clusterIndex < 0) {
    return;
  }

  ClusterRuntime& cluster = gClusters[clusterIndex];
  const bool firstStatusForCluster = cluster.lastSeenAtMs == 0;
  cluster.online = true;
  cluster.clusterId = status.clusterId;
  cluster.lastSequence = status.sequence;
  cluster.lastActiveDerricks = status.activeDerricks > kMaxDerricks ? kMaxDerricks : status.activeDerricks;
  cluster.lastPirBits = status.pirStateBits;
  cluster.lastHealthFlags = status.healthFlags;
  cluster.lastSeenAtMs = nowMs;
  cluster.lastStatusUptimeMs = status.uptimeMs;
  cluster.desiredCommand.clusterId = status.clusterId;
  cluster.desiredCommand.activeDerricks = cluster.lastActiveDerricks;
  if (firstStatusForCluster) {
    applyCachedArtNetUniverse(status.clusterId);
  }
}

void printClusterSummary(const ClusterRuntime& cluster) {
  char macBuffer[18] = {};
  formatMac(cluster.mac, macBuffer, sizeof(macBuffer));

  Serial.print("Cluster ");
  Serial.print(cluster.clusterId);
  Serial.print(" [");
  Serial.print(macBuffer);
  Serial.print("] online=");
  Serial.print(cluster.online ? "yes" : "no");
  Serial.print(" pir=");
  Serial.print(cluster.lastPirBits, BIN);
  Serial.print(" health=0x");
  Serial.print(cluster.lastHealthFlags, HEX);
  Serial.print(" uptimeMs=");
  Serial.println(cluster.lastStatusUptimeMs);
}

void renderStatusPage(uint32_t nowMs, bool includeSerialOutput = true) {
  writeOledStatusPage(nowMs);

  if (!kEnableSerialLogs || !includeSerialOutput) {
    return;
  }

  Serial.println("--- MCU Status ---");
  for (uint8_t i = 0; i < kMaxClusters; ++i) {
    if (gClusters[i].occupied) {
      printClusterSummary(gClusters[i]);
    }
  }
}

const char* movementSpeedName(MovementSpeed speed) {
  switch (speed) {
    case kMovementSpeedSlow:
      return "slow";
    case kMovementSpeedMedium:
      return "medium";
    case kMovementSpeedFast:
    default:
      return "fast";
  }
}

void printIntendedDerekState() {
  Serial.println("--- Intended Derek State ---");
  Serial.println("Cached MCU targets; compare with physical positions.");

  for (uint8_t clusterIndex = 0; clusterIndex < kMaxClusters; ++clusterIndex) {
    const ClusterRuntime& cluster = gClusters[clusterIndex];
    if (!cluster.occupied) {
      continue;
    }

    Serial.print("C");
    Serial.print(cluster.clusterId);
    Serial.print(" online=");
    Serial.print(cluster.online ? "yes" : "no");
    Serial.print(" active=");
    Serial.print(cluster.desiredCommand.activeDerricks);
    Serial.print(" speed=");
    Serial.print(movementSpeedName(cluster.movementSpeed));
    Serial.print(" flags=0x");
    Serial.println(cluster.desiredCommand.flags, HEX);

    for (uint8_t derekIndex = 0; derekIndex < kMaxDerricks; ++derekIndex) {
      const DerekCommand& derek = cluster.desiredCommand.derricks[derekIndex];
      Serial.print("  D");
      Serial.print(derekIndex + 1);
      Serial.print(" pan=");
      Serial.print(derek.pan);
      Serial.print(" lift=");
      Serial.println(derek.lift);
    }
  }
}

void initializeDisplayHardware() {
  Wire.begin(kI2cSdaPin, kI2cSclPin);
  gOledReady = initializeOled();
  if (gOledReady) {
    clearOled();
    char line[22] = {};
    snprintf(
        line,
        sizeof(line),
        "MCU V%u.%u.%u",
        kSoftwareVersionMajor,
        kSoftwareVersionMinor,
        kSoftwareVersionRevision);
    writeOledLine(0, line);
    writeOledLine(1, "OLED READY");
    writeOledLine(2, "DISCOVERY ON");
  }
}

void updateButtonInputs() {
  // TODO: Replace with actual page navigation once button pins and OLED are known.
  if (kButtonNextPin >= 0) {
    pinMode(kButtonNextPin, INPUT_PULLUP);
  }
  if (kButtonPrevPin >= 0) {
    pinMode(kButtonPrevPin, INPUT_PULLUP);
  }
}

void initializeTestModeInputs() {
  pinMode(kTestModeSwitchPin, INPUT_PULLUP);
  pinMode(kTestAllUpButtonPin, INPUT_PULLUP);
  pinMode(kTestAllDownButtonPin, INPUT_PULLUP);

  gTestModeEnabled = digitalRead(kTestModeSwitchPin) == LOW;
  gTestAllUpButtonWasPressed = digitalRead(kTestAllUpButtonPin) == LOW;
  gTestAllDownButtonWasPressed = digitalRead(kTestAllDownButtonPin) == LOW;

  if (!gTestModeEnabled) {
    return;
  }

  writeOledTestModePage();
  Serial.println("MCU test mode enabled: Art-Net input paused; GPIO5=All Up, GPIO6=All Down.");
}

void initializeRemoteInputs() {
  const uint32_t nowMs = millis();
  for (uint8_t buttonIndex = 0; buttonIndex < kRemoteButtonCount; ++buttonIndex) {
    // RX480E D0-D3 are driven CMOS outputs, so do not enable an internal
    // pull-up that could disguise an unpowered receiver as a button press.
    pinMode(kRemoteButtonPins[buttonIndex], INPUT);
    gRemoteButtonWasPressed[buttonIndex] =
        digitalRead(kRemoteButtonPins[buttonIndex]) == HIGH;
    gRemoteLastButtonEventAtMs[buttonIndex] = nowMs - kRemoteButtonDebounceMs;
  }
}

void markOfflineClusters(uint32_t nowMs) {
  for (uint8_t i = 0; i < kMaxClusters; ++i) {
    if (!gClusters[i].occupied) {
      continue;
    }

    gClusters[i].online = (nowMs - gClusters[i].lastSeenAtMs) <= kClusterOfflineMs;
  }
}

void setAllDerekNeutral(ClusterCommandPacket& command) {
  for (uint8_t i = 0; i < kMaxDerricks; ++i) {
    command.derricks[i].pan = 90;
    command.derricks[i].lift = kDerekLiftMinimum;
  }
}

void applyBootDerekTestPose(ClusterRuntime& cluster, uint8_t derekIndex, BootDerekTestPhase phase) {
  ClusterCommandPacket& command = cluster.desiredCommand;
  setAllDerekNeutral(command);
  command.flags = kCommandFlagApplyOutputs | kCommandFlagRequestStatus;
  cluster.commandDirty = true;
  command.activeDerricks = kMaxDerricks;

  if (derekIndex >= kMaxDerricks) {
    return;
  }

  DerekCommand& derek = command.derricks[derekIndex];
  derek.spotlightColor = {40, 40, 40};
  derek.rightEyeColor = {0, 0, 0};
  derek.leftEyeColor = {0, 0, 0};

  switch (phase) {
    case kBootDerekTestLift:
      derek.pan = 90;
      derek.lift = 170;
      break;
    case kBootDerekTestLeft:
      derek.pan = 10;
      derek.lift = 170;
      break;
    case kBootDerekTestRight:
      derek.pan = 170;
      derek.lift = 170;
      break;
    case kBootDerekTestCenter:
      derek.pan = 90;
      derek.lift = 170;
      break;
    case kBootDerekTestLower:
      derek.pan = 90;
      derek.lift = 0;
      derek.spotlightColor = {0, 0, 0};
      break;
    default:
      break;
  }
}

void finishBootDerekTest() {
  for (uint8_t i = 0; i < kMaxClusters; ++i) {
    if (gClusters[i].occupied) {
      setAllDerekNeutral(gClusters[i].desiredCommand);
      gClusters[i].desiredCommand.flags = kCommandFlagApplyOutputs | kCommandFlagRequestStatus;
      gClusters[i].commandDirty = true;
    }
  }
  gBootDerekTestRunning = false;
  gBootDerekTestDone = true;
  Serial.println("Boot Derek test complete.");
}

void advanceBootDerekTestCursor() {
  if (gBootDerekTestPhase < kBootDerekTestLower) {
    gBootDerekTestPhase = static_cast<BootDerekTestPhase>(gBootDerekTestPhase + 1);
    return;
  }

  gBootDerekTestPhase = kBootDerekTestLift;
  ++gBootDerekTestDerekCursor;
  if (gBootDerekTestDerekCursor < gClusters[gBootDerekTestClusterCursor].lastActiveDerricks) {
    return;
  }

  gBootDerekTestDerekCursor = 0;
  const int8_t nextCluster = findNextOnlineClusterIndex(gBootDerekTestClusterCursor + 1);
  if (nextCluster >= 0) {
    gBootDerekTestClusterCursor = static_cast<uint8_t>(nextCluster);
    return;
  }

  finishBootDerekTest();
}

void runBootDerekTest(uint32_t nowMs) {
  if (gBootDerekTestDone) {
    return;
  }

  if (!gBootDerekTestRunning) {
    if ((nowMs - gBootStartedAtMs) < kBootDerekTestWaitMs) {
      return;
    }

    const int8_t firstCluster = findNextOnlineClusterIndex(0);
    if (firstCluster < 0) {
      finishBootDerekTest();
      Serial.println("Boot Derek test skipped; no registered clusters.");
      return;
    }

    gBootDerekTestRunning = true;
    gBootDerekTestClusterCursor = static_cast<uint8_t>(firstCluster);
    gBootDerekTestDerekCursor = 0;
    gBootDerekTestPhase = kBootDerekTestLift;
    gLastBootDerekTestStepAtMs = 0;
    Serial.println("Boot Derek test started.");
  }

  if ((nowMs - gLastBootDerekTestStepAtMs) < kBootDerekTestStepMs) {
    return;
  }

  gLastBootDerekTestStepAtMs = nowMs;
  if (!gClusters[gBootDerekTestClusterCursor].occupied || !gClusters[gBootDerekTestClusterCursor].online ||
      gClusters[gBootDerekTestClusterCursor].lastActiveDerricks == 0) {
    const int8_t nextCluster = findNextOnlineClusterIndex(gBootDerekTestClusterCursor + 1);
    if (nextCluster < 0) {
      finishBootDerekTest();
      return;
    }
    gBootDerekTestClusterCursor = static_cast<uint8_t>(nextCluster);
    gBootDerekTestDerekCursor = 0;
    gBootDerekTestPhase = kBootDerekTestLift;
  }

  ClusterRuntime& cluster = gClusters[gBootDerekTestClusterCursor];
  applyBootDerekTestPose(cluster, gBootDerekTestDerekCursor, gBootDerekTestPhase);

  Serial.print("Boot test C");
  Serial.print(cluster.clusterId);
  Serial.print(" Derek ");
  Serial.print(gBootDerekTestDerekCursor + 1);
  Serial.print(" ");
  Serial.println(bootDerekTestPhaseName());

  advanceBootDerekTestCursor();
}

void printRadioDebugSummary() {
  Serial.print("ESP-NOW queued=");
  Serial.print(gEspNowPacketsQueued);
  Serial.print(" queueFail=");
  Serial.print(gEspNowQueueFailures);
  Serial.print(" sendOk=");
  Serial.print(gEspNowSendSuccesses);
  Serial.print(" sendFail=");
  Serial.print(gEspNowSendFailures);
  Serial.print(" last C");
  Serial.print(gLastEspNowClusterId);
  Serial.print(" seq=");
  Serial.print(gLastEspNowSequence);
  Serial.print(" flags=0x");
  Serial.print(gLastEspNowFlags, HEX);
  Serial.print(" queueResult=");
  Serial.print(gLastEspNowQueueResult);
  Serial.print(" cbStatus=");
  Serial.println(gLastEspNowSendStatus);
}

void maybePrintRadioDebugSummary(uint32_t nowMs) {
  if (!kEnableSerialLogs || !kEnableRadioDebugLogs) {
    return;
  }

  if ((nowMs - gLastRadioDebugLogAtMs) < kRadioDebugLogIntervalMs) {
    return;
  }

  gLastRadioDebugLogAtMs = nowMs;
  printRadioDebugSummary();
}

bool sendCommandToCluster(ClusterRuntime& cluster, uint8_t clusterIndex) {
  if (gEspNowSendInFlight) {
    return false;
  }

  cluster.desiredCommand.magic = kProtocolMagic;
  cluster.desiredCommand.version = kProtocolVersion;
  cluster.desiredCommand.kind = kMessageCommand;
  cluster.desiredCommand.sequence = gSequenceCounter++;
  cluster.desiredCommand.movementSpeed = cluster.movementSpeed;

  const uint16_t sentSequence = cluster.desiredCommand.sequence;
  const uint8_t sentFlags = cluster.desiredCommand.flags;
  // Register the ownership before queuing: on fast links the send callback
  // can run before esp_now_send returns.
  gEspNowInFlightClusterIndex = static_cast<int8_t>(clusterIndex);
  gEspNowSendInFlight = true;
  const esp_err_t sendResult = esp_now_send(
      cluster.mac,
      reinterpret_cast<const uint8_t*>(&cluster.desiredCommand),
      sizeof(cluster.desiredCommand));

  gLastEspNowQueuedAtMs = millis();
  gLastEspNowClusterId = cluster.clusterId;
  gLastEspNowSequence = sentSequence;
  gLastEspNowFlags = sentFlags;
  gLastEspNowQueueResult = static_cast<int>(sendResult);
  if (sendResult == ESP_OK) {
    ++gEspNowPacketsQueued;
    cluster.commandDirty = false;
    cluster.lastCommandSentAtMs = gLastEspNowQueuedAtMs;
  } else {
    gEspNowInFlightClusterIndex = -1;
    gEspNowSendInFlight = false;
    ++gEspNowQueueFailures;
    if (kEnableSerialLogs) {
      Serial.print("ESP-NOW queue failed C");
      Serial.print(cluster.clusterId);
      Serial.print(" seq=");
      Serial.print(sentSequence);
      Serial.print(" result=");
      Serial.println(gLastEspNowQueueResult);
    }
  }
  maybePrintRadioDebugSummary(gLastEspNowQueuedAtMs);

  cluster.desiredCommand.flags &= kCommandFlagApplyOutputs;
  cluster.desiredCommand.audioTrackA = 0;
  cluster.desiredCommand.audioTrackB = 0;
  return sendResult == ESP_OK;
}

void applyAllDerekLiftTargetToCluster(ClusterRuntime& cluster, uint8_t liftTarget) {
  ClusterCommandPacket& command = cluster.desiredCommand;
  command.flags = kCommandFlagApplyOutputs | kCommandFlagRequestStatus;
  command.activeDerricks = kMaxDerricks;
  cluster.movementSpeed = kMovementSpeedFast;
  command.movementSpeed = kMovementSpeedFast;

  for (uint8_t derekIndex = 0; derekIndex < kMaxDerricks; ++derekIndex) {
    command.derricks[derekIndex].lift = liftTarget;
  }
  cluster.commandDirty = true;
}

void sendAllDerekLiftTargetToAllClusters(uint8_t liftTarget) {
  for (uint8_t clusterIndex = 0; clusterIndex < kMaxClusters; ++clusterIndex) {
    ClusterRuntime& cluster = gClusters[clusterIndex];
    if (!cluster.occupied) {
      continue;
    }

    applyAllDerekLiftTargetToCluster(cluster, liftTarget);
    // Let the normal scheduler serialize this burst.  Calling esp_now_send
    // once per cluster here can overflow the radio's small TX queue.
  }
}

void applyTestLiftStateToCluster(ClusterRuntime& cluster) {
  const uint8_t liftTarget = gTestLiftState == kTestLiftAllUp ? kDerekLiftMaximum : kDerekLiftMinimum;
  applyAllDerekLiftTargetToCluster(cluster, liftTarget);
}

void sendTestLiftStateToAllClusters() {
  const uint8_t liftTarget = gTestLiftState == kTestLiftAllUp ? kDerekLiftMaximum : kDerekLiftMinimum;
  sendAllDerekLiftTargetToAllClusters(liftTarget);
}

void updateTestModeInputs(uint32_t nowMs) {
  const bool allUpPressed = digitalRead(kTestAllUpButtonPin) == LOW;
  const bool allDownPressed = digitalRead(kTestAllDownButtonPin) == LOW;
  const bool debounceElapsed = (nowMs - gTestLastButtonEventAtMs) >= kTestButtonDebounceMs;

  if (allUpPressed && !gTestAllUpButtonWasPressed && debounceElapsed) {
    gTestLiftState = kTestLiftAllUp;
    gTestLastButtonEventAtMs = nowMs;
    sendTestLiftStateToAllClusters();
    writeOledTestModePage();
    Serial.println("Test mode: commanded all Derek units UP.");
  } else if (allDownPressed && !gTestAllDownButtonWasPressed && debounceElapsed) {
    gTestLiftState = kTestLiftAllDown;
    gTestLastButtonEventAtMs = nowMs;
    sendTestLiftStateToAllClusters();
    writeOledTestModePage();
    Serial.println("Test mode: commanded all Derek units DOWN.");
  }

  gTestAllUpButtonWasPressed = allUpPressed;
  gTestAllDownButtonWasPressed = allDownPressed;
}

void updateRemoteInputs(uint32_t nowMs) {
  for (uint8_t buttonIndex = 0; buttonIndex < kRemoteButtonCount; ++buttonIndex) {
    const bool pressed = digitalRead(kRemoteButtonPins[buttonIndex]) == HIGH;
    const bool debounceElapsed =
        (nowMs - gRemoteLastButtonEventAtMs[buttonIndex]) >= kRemoteButtonDebounceMs;

    if (pressed && !gRemoteButtonWasPressed[buttonIndex] && debounceElapsed) {
      gRemoteLastButtonEventAtMs[buttonIndex] = nowMs;
      gLastRemoteButtonIndex = buttonIndex;
      if (!gTestModeEnabled) {
        writeOledStatusPage(nowMs);
      }
      if (sendQlcOscRemoteEvent(buttonIndex, true)) {
        queueRemoteOscRelease(buttonIndex, nowMs);
        if (kEnableSerialLogs) {
          Serial.print("Remote ");
          Serial.print(kRemoteButtonNames[buttonIndex]);
          Serial.println(" requested its QLC+ show.");
        }
      } else {
        Serial.print("Remote ");
        Serial.print(kRemoteButtonNames[buttonIndex]);
        Serial.println(" OSC send failed.");
      }
    }

    gRemoteButtonWasPressed[buttonIndex] = pressed;
  }
}

void runBootMassLiftTest(uint32_t nowMs) {
  switch (gBootMassTestPhase) {
    case kBootMassTestWaitingForClusters:
      if ((nowMs - gBootMassTestPhaseStartedAtMs) < kBootMassTestDiscoveryWaitMs) {
        return;
      }
      if (countOnlineClusters() == 0) {
        gBootMassTestPhase = kBootMassTestDone;
        Serial.println("Boot mass test skipped; no online clusters.");
        return;
      }
      sendAllDerekLiftTargetToAllClusters(kDerekLiftMaximum);
      gBootMassTestPhase = kBootMassTestAllUp;
      gBootMassTestPhaseStartedAtMs = nowMs;
      Serial.println("Boot mass test: all Derek units UP.");
      return;

    case kBootMassTestAllUp:
      if ((nowMs - gBootMassTestPhaseStartedAtMs) < kBootMassTestAllUpHoldMs) {
        return;
      }
      sendAllDerekLiftTargetToAllClusters(kDerekLiftMinimum);
      gBootMassTestPhase = kBootMassTestDone;
      Serial.println("Boot mass test: all Derek units DOWN; complete.");
      return;

    case kBootMassTestDone:
    default:
      return;
  }
}

void initializeWifiAndArtNet() {
  WiFi.mode(WIFI_STA);

  if (strlen(kWifiSsid) > 0) {
    WiFi.begin(kWifiSsid, kWifiPassword);
    const uint32_t startedAtMs = millis();
    while (WiFi.status() != WL_CONNECTED && (millis() - startedAtMs) < 8000) {
      delay(50);
    }
  } else {
    WiFi.disconnect(false, true);
  }

  gArtNetUdp.begin(kArtNetListenPort);
  gQlcOscUdp.begin(0);

  if (gOledReady) {
    if (WiFi.status() == WL_CONNECTED) {
      char ipBuffer[16] = {};
      formatIpAddress(WiFi.localIP(), ipBuffer, sizeof(ipBuffer));
      char line[22] = {};
      snprintf(line, sizeof(line), "IP %s", ipBuffer);
      writeOledLine(1, "WIFI CONNECTED");
      writeOledLine(2, line);
    } else {
      writeOledLine(1, "WIFI NOT CONNECTED");
      writeOledLine(2, "NO IP ADDRESS");
    }
  }

  if (!kEnableSerialLogs) {
    return;
  }

  Serial.print("Wi-Fi MAC: ");
  Serial.println(WiFi.macAddress());
  Serial.print("Wi-Fi channel: ");
  Serial.println(WiFi.channel());
  Serial.print("Art-Net listen port: ");
  Serial.println(kArtNetListenPort);
  char qlcOscHostText[16] = {};
  formatIpAddress(gQlcOscHost, qlcOscHostText, sizeof(qlcOscHostText));
  Serial.print("QLC+ OSC target: ");
  Serial.print(qlcOscHostText);
  Serial.print(":");
  Serial.println(kQlcOscPort);
  if (WiFi.status() == WL_CONNECTED) {
    Serial.println("Wi-Fi connected.");
    Serial.print("Wi-Fi IP: ");
    Serial.println(WiFi.localIP());
  } else {
    Serial.println("Wi-Fi is not connected; ESP-NOW and serial tests are still available.");
  }
}

void broadcastDiscovery() {
  ClusterCommandPacket discovery = {};
  discovery.magic = kProtocolMagic;
  discovery.version = kProtocolVersion;
  discovery.kind = kMessageCommand;
  discovery.clusterId = kBroadcastClusterId;
  discovery.sequence = gSequenceCounter++;
  discovery.flags = kCommandFlagDiscovery | kCommandFlagRequestStatus;
  discovery.activeDerricks = kMaxDerricks;

  esp_now_send(kBroadcastMac, reinterpret_cast<const uint8_t*>(&discovery), sizeof(discovery));
}

void sendScheduledCommands(uint32_t nowMs) {
  if ((nowMs - gLastCommandAtMs) < kCommandIntervalMs) {
    return;
  }

  gLastCommandAtMs = nowMs;

  // Send callbacks run outside the sketch loop.  Move the retry request into
  // the loop before touching the normal command cache.
  const int8_t failedClusterIndex = gEspNowFailedClusterIndex;
  if (failedClusterIndex >= 0 && failedClusterIndex < kMaxClusters) {
    gClusters[failedClusterIndex].commandDirty = true;
    gEspNowFailedClusterIndex = -1;
  }

  if (gEspNowSendInFlight) {
    return;
  }

  // Round-robin selection prevents lower-numbered clusters from starving
  // during a sustained multi-universe QLC+ update.
  for (uint8_t offset = 0; offset < kMaxClusters; ++offset) {
    const uint8_t i = (gNextCommandClusterIndex + offset) % kMaxClusters;
    if (!gClusters[i].occupied || !gClusters[i].online) {
      continue;
    }

    const bool heartbeatDue =
        gClusters[i].lastCommandSentAtMs == 0 || (nowMs - gClusters[i].lastCommandSentAtMs) >= kCommandHeartbeatMs;
    const bool urgentCommandPending =
        gClusters[i].commandDirty &&
        (gClusters[i].desiredCommand.flags &
         (kCommandFlagAudioA | kCommandFlagAudioB | kCommandFlagEmergencyHide)) != 0;
    const bool outputFrameDue =
        gClusters[i].commandDirty &&
        (gClusters[i].lastCommandSentAtMs == 0 ||
         (nowMs - gClusters[i].lastCommandSentAtMs) >= kOutputFrameIntervalMs);

    if (urgentCommandPending || outputFrameDue || heartbeatDue) {
      if (sendCommandToCluster(gClusters[i], i)) {
        gNextCommandClusterIndex = (i + 1) % kMaxClusters;
      }
      return;
    }
  }
}

void handlePirEvent(const ClusterRuntime& cluster, uint8_t priorPirBits, uint8_t newPirBits) {
  if (priorPirBits == newPirBits) {
    return;
  }

  Serial.print("PIR change from cluster ");
  Serial.print(cluster.clusterId);
  Serial.print(": ");
  Serial.print(priorPirBits, BIN);
  Serial.print(" -> ");
  Serial.println(newPirBits, BIN);
}

void handleStatusPacket(const uint8_t* macAddress, const ClusterStatusPacket& status, uint32_t nowMs) {
  int8_t clusterIndex = reserveClusterSlot(macAddress, status.clusterId);
  if (clusterIndex < 0) {
    return;
  }

  const uint8_t previousPirBits = gClusters[clusterIndex].lastPirBits;
  updateClusterFromStatus(macAddress, status, nowMs);
  if (gTestModeEnabled) {
    applyTestLiftStateToCluster(gClusters[clusterIndex]);
  } else if (gBootMassTestPhase == kBootMassTestAllUp) {
    applyAllDerekLiftTargetToCluster(gClusters[clusterIndex], kDerekLiftMaximum);
  }
  handlePirEvent(gClusters[clusterIndex], previousPirBits, status.pirStateBits);
  publishPirRisingEdges(status.clusterId, previousPirBits, status.pirStateBits, nowMs);
}

void applyArtNetDmxFrame(uint8_t clusterId, const uint8_t* dmxData, uint16_t dmxLength) {
  if (clusterId >= kMaxClusters || dmxData == nullptr) {
    ++gArtNetFramesRejected;
    return;
  }

  const uint16_t channelsToCache = min<uint16_t>(dmxLength, kChannelsPerCluster);
  const bool firstFrameForUniverse = !gArtNetUniverseSeen[clusterId];
  gArtNetUniverseSeen[clusterId] = true;
  ++gArtNetFramesAccepted;
  gLastArtNetFrameAtMs = millis();

  const int8_t clusterIndex = findClusterIndexById(clusterId);
  for (uint16_t channelIndex = 0; channelIndex < channelsToCache; ++channelIndex) {
    const uint8_t value = dmxData[channelIndex];
    const bool changed = firstFrameForUniverse || gArtNetDmx[clusterId][channelIndex] != value;
    gArtNetDmx[clusterId][channelIndex] = value;
    if (changed) {
      gLastArtNetCommandValid = true;
      gLastArtNetCommandClusterId = clusterId;
      gLastArtNetCommandChannel = channelIndex + 1;
      gLastArtNetCommandValue = value;
      if (clusterIndex >= 0) {
        applyDmxChannelToCluster(gClusters[clusterIndex], channelIndex + 1, value);
      }
    }
  }
}

void handleArtNetPacket(const uint8_t* data, size_t len) {
  constexpr uint8_t kArtNetId[] = {'A', 'r', 't', '-', 'N', 'e', 't', '\0'};
  constexpr uint16_t kArtNetOpDmx = 0x5000;
  constexpr size_t kArtNetDmxHeaderSize = 18;

  if (len < 10 || memcmp(data, kArtNetId, sizeof(kArtNetId)) != 0) {
    ++gArtNetFramesRejected;
    return;
  }

  const uint16_t opcode = static_cast<uint16_t>(data[8]) | (static_cast<uint16_t>(data[9]) << 8);
  if (opcode != kArtNetOpDmx) {
    return;
  }
  if (len < kArtNetDmxHeaderSize) {
    ++gArtNetFramesRejected;
    return;
  }

  const uint16_t universe = static_cast<uint16_t>(data[14]) | (static_cast<uint16_t>(data[15]) << 8);
  const uint16_t dmxLength = (static_cast<uint16_t>(data[16]) << 8) | data[17];
  if (universe >= kMaxClusters || dmxLength == 0 || dmxLength > 512 || kArtNetDmxHeaderSize + dmxLength > len) {
    ++gArtNetFramesRejected;
    return;
  }

  // QLC+ universe IDs 0-14 map directly to cluster/DIP IDs 0-14.
  applyArtNetDmxFrame(static_cast<uint8_t>(universe), data + kArtNetDmxHeaderSize, dmxLength);
}

void updateArtNetInput() {
  static uint8_t packetBuffer[kArtNetPacketBufferSize] = {};

  for (uint8_t packetsRead = 0; packetsRead < kMaxArtNetPacketsPerLoop; ++packetsRead) {
    const int packetSize = gArtNetUdp.parsePacket();
    if (packetSize <= 0) {
      return;
    }

    const size_t bytesRead = gArtNetUdp.read(packetBuffer, min(packetSize, static_cast<int>(sizeof(packetBuffer))));
    ++gArtNetPacketsReceived;
    if (packetSize > static_cast<int>(sizeof(packetBuffer))) {
      ++gArtNetFramesRejected;
      continue;
    }
    handleArtNetPacket(packetBuffer, bytesRead);
  }
}

void parseSerialCommand(char* line) {
  char command[16] = {};
  char argument[16] = {};
  int clusterId = 0;
  int derrickIndex = 0;
  int a = 0;
  int b = 0;
  int c = 0;

  if (sscanf(line, "%15s", command) != 1) {
    return;
  }

  if (strcmp(command, "list") == 0) {
    renderStatusPage(millis());
    return;
  }

  if (strcmp(command, "showstate") == 0) {
    printIntendedDerekState();
    return;
  }

  if (strcmp(command, "artnet") == 0) {
    Serial.print("Art-Net packets=");
    Serial.print(gArtNetPacketsReceived);
    Serial.print(" accepted=");
    Serial.print(gArtNetFramesAccepted);
    Serial.print(" rejected=");
    Serial.print(gArtNetFramesRejected);
    Serial.print(" lastAtMs=");
    Serial.println(gLastArtNetFrameAtMs);
    return;
  }

  if (strcmp(command, "radio") == 0) {
    printRadioDebugSummary();
    return;
  }

  if (strcmp(command, "osc") == 0) {
    char hostText[16] = {};
    if (sscanf(line, "%15s %15s %15s", command, argument, hostText) == 1) {
      char configuredHostText[16] = {};
      formatIpAddress(gQlcOscHost, configuredHostText, sizeof(configuredHostText));
      Serial.print("QLC+ OSC target: ");
      Serial.print(configuredHostText);
      Serial.print(":");
      Serial.println(kQlcOscPort);
    } else if (strcmp(argument, "host") == 0) {
      IPAddress configuredHost;
      if (parseIpAddress(hostText, configuredHost)) {
        gQlcOscHost = configuredHost;
        gMcuPreferences.putString("qlcOscHost", hostText);
        Serial.println("QLC+ OSC target saved.");
      } else {
        Serial.println("Invalid OSC host IP address.");
      }
    } else {
      Serial.println("Usage: osc [host <IPv4-address>]");
    }
    return;
  }

  if (strcmp(command, "speed") == 0) {
    char speedName[8] = {};
    MovementSpeed movementSpeed = kMovementSpeedFast;
    if (sscanf(line, "%15s %d %7s", command, &clusterId, speedName) == 3 &&
        parseMovementSpeedName(speedName, movementSpeed)) {
      const int8_t clusterIndex = findClusterIndexById(static_cast<uint8_t>(clusterId));
      if (clusterIndex >= 0) {
        gClusters[clusterIndex].movementSpeed = movementSpeed;
        gClusters[clusterIndex].desiredCommand.movementSpeed = movementSpeed;
        gClusters[clusterIndex].desiredCommand.flags |= kCommandFlagRequestStatus;
        gClusters[clusterIndex].commandDirty = true;
      }
    }
    return;
  }

  if (strcmp(command, "dmx") == 0 &&
      sscanf(line, "%15s %d %d %d", command, &clusterId, &a, &b) == 4) {
    const int8_t clusterIndex = findClusterIndexById(static_cast<uint8_t>(clusterId));
    if (clusterIndex >= 0) {
      applyDmxChannelToCluster(
          gClusters[clusterIndex],
          static_cast<uint16_t>(constrain(a, 1, 512)),
          static_cast<uint8_t>(constrain(b, 0, 255)));
    }
    return;
  }

  if (strcmp(command, "audio") == 0 &&
      sscanf(line, "%15s %d %d %d", command, &clusterId, &a, &b) == 4) {
    const int8_t clusterIndex = findClusterIndexById(static_cast<uint8_t>(clusterId));
    if (clusterIndex >= 0) {
      ClusterCommandPacket& packet = gClusters[clusterIndex].desiredCommand;
      if (a == 1) {
        packet.audioTrackA = static_cast<uint16_t>(constrain(b, 1, 3000));
        packet.flags |= kCommandFlagAudioA | kCommandFlagRequestStatus;
        gClusters[clusterIndex].commandDirty = true;
      } else if (a == 2) {
        packet.audioTrackB = static_cast<uint16_t>(constrain(b, 1, 3000));
        packet.flags |= kCommandFlagAudioB | kCommandFlagRequestStatus;
        gClusters[clusterIndex].commandDirty = true;
      }
    }
    return;
  }

  if (strcmp(command, "hide") == 0 && sscanf(line, "%15s %d", command, &clusterId) == 2) {
    const int8_t clusterIndex = findClusterIndexById(static_cast<uint8_t>(clusterId));
    if (clusterIndex >= 0) {
      gClusters[clusterIndex].desiredCommand.flags = kCommandFlagEmergencyHide | kCommandFlagRequestStatus;
      gClusters[clusterIndex].commandDirty = true;
    }
    return;
  }

  if (strcmp(command, "track") == 0 &&
      sscanf(line, "%15s %d %d %d %d", command, &clusterId, &derrickIndex, &a, &b) == 5) {
    const int8_t clusterIndex = findClusterIndexById(static_cast<uint8_t>(clusterId));
    if (clusterIndex >= 0 && derrickIndex >= 0 && derrickIndex < kMaxDerricks) {
      ClusterCommandPacket& packet = gClusters[clusterIndex].desiredCommand;
      packet.flags = kCommandFlagApplyOutputs | kCommandFlagRequestStatus;
      packet.derricks[derrickIndex].pan = constrain(a, 0, 180);
      packet.derricks[derrickIndex].lift = constrain(b, 0, 170);
      gClusters[clusterIndex].commandDirty = true;
    }
    return;
  }

  if (strcmp(command, "eyes") == 0 &&
      sscanf(line, "%15s %d %d %d %d %d", command, &clusterId, &derrickIndex, &a, &b, &c) == 6) {
    const int8_t clusterIndex = findClusterIndexById(static_cast<uint8_t>(clusterId));
    if (clusterIndex >= 0 && derrickIndex >= 0 && derrickIndex < kMaxDerricks) {
      ClusterCommandPacket& packet = gClusters[clusterIndex].desiredCommand;
      packet.flags = kCommandFlagApplyOutputs | kCommandFlagRequestStatus;
      packet.derricks[derrickIndex].spotlightColor = {
          static_cast<uint8_t>(constrain(a, 0, 255)),
          static_cast<uint8_t>(constrain(b, 0, 255)),
          static_cast<uint8_t>(constrain(c, 0, 255))};
      gClusters[clusterIndex].commandDirty = true;
    }
    return;
  }

  Serial.println("Commands: list | showstate | artnet | radio | osc [host <IPv4-address>] | speed <cluster> <fast|medium|slow> | hide <cluster> | track <cluster> <derrick 0-7> <pan> <lift> | eyes <cluster> <derrick 0-7> <r> <g> <b> | dmx <cluster> <channel> <value> | audio <cluster> <player 1-2> <track>");
}

void updateSerialConsole() {
  static char lineBuffer[96] = {};
  static uint8_t lineLength = 0;

  while (Serial.available() > 0) {
    const char next = static_cast<char>(Serial.read());
    if (next == '\r') {
      continue;
    }

    if (next == '\n') {
      lineBuffer[lineLength] = '\0';
      parseSerialCommand(lineBuffer);
      lineLength = 0;
      continue;
    }

    if (lineLength < sizeof(lineBuffer) - 1) {
      lineBuffer[lineLength++] = next;
    }
  }
}

#if ESP_ARDUINO_VERSION_MAJOR >= 3
void onEspNowReceive(const esp_now_recv_info_t* info, const uint8_t* data, int len) {
  if (info == nullptr || data == nullptr || len <= 0 || !isProtocolPacketValid(data, static_cast<size_t>(len))) {
    return;
  }

  const uint8_t* senderMac = info->src_addr;
#else
void onEspNowReceive(const uint8_t* senderMac, const uint8_t* data, int len) {
  if (senderMac == nullptr || data == nullptr || len <= 0 || !isProtocolPacketValid(data, static_cast<size_t>(len))) {
    return;
  }
#endif
  const uint8_t kind = data[3];
  if ((kind == kMessageRegister || kind == kMessageStatus) && static_cast<size_t>(len) == sizeof(ClusterStatusPacket)) {
    ClusterStatusPacket status = {};
    memcpy(&status, data, sizeof(status));
    handleStatusPacket(senderMac, status, millis());
  }
}

#if ESP_ARDUINO_VERSION_MAJOR >= 3
void onEspNowSend(const wifi_tx_info_t* txInfo, esp_now_send_status_t status) {
  (void)txInfo;
#else
void onEspNowSend(const uint8_t* macAddr, esp_now_send_status_t status) {
  (void)macAddr;
#endif
  const int8_t clusterIndex = gEspNowInFlightClusterIndex;
  gEspNowInFlightClusterIndex = -1;
  gEspNowSendInFlight = false;
  gLastEspNowCallbackAtMs = millis();
  gLastEspNowSendStatus = static_cast<int>(status);
  if (status == ESP_NOW_SEND_SUCCESS) {
    ++gEspNowSendSuccesses;
  } else {
    ++gEspNowSendFailures;
    // A packet accepted by the local ESP-NOW queue can still fail over the
    // air.  Re-mark its cached pose so the scheduler retries immediately,
    // rather than waiting for the 750 ms heartbeat.
    gEspNowFailedClusterIndex = clusterIndex;
  }
}

bool initializeEspNow() {
  if (esp_now_init() != ESP_OK) {
    return false;
  }

  addEspNowPeer(kBroadcastMac);
  esp_now_register_recv_cb(onEspNowReceive);
  esp_now_register_send_cb(onEspNowSend);
  return true;
}

}  // namespace

void setup() {
  if (kEnableSerialLogs) {
    Serial.begin(115200);
  }

  memset(gClusters, 0, sizeof(gClusters));
  gBootStartedAtMs = millis();
  loadQlcOscConfiguration();
  initializeDisplayHardware();
  updateButtonInputs();
  initializeWifiAndArtNet();

  if (!initializeEspNow()) {
    Serial.println("ESP-NOW init failed.");
    return;
  }

  gBootMassTestPhaseStartedAtMs = millis();
  initializeTestModeInputs();
  initializeRemoteInputs();

  Serial.print("MCU gateway ready. Version ");
  Serial.print(kSoftwareVersionMajor);
  Serial.print(".");
  Serial.print(kSoftwareVersionMinor);
  Serial.print(".");
  Serial.println(kSoftwareVersionRevision);
  Serial.println("Serial console commands: list, showstate, artnet, radio, osc, speed, hide, track, eyes, dmx, audio");
}

void loop() {
  const uint32_t nowMs = millis();
  updateRemoteInputs(nowMs);
  servicePendingRemoteOscReleases(nowMs);

  if (gTestModeEnabled) {
    // Keep cluster discovery, registration callbacks, status processing, and
    // ESP-NOW heartbeats remain active while Art-Net input is paused.
    markOfflineClusters(nowMs);

    if ((nowMs - gLastDiscoveryAtMs) >= kDiscoveryIntervalMs) {
      broadcastDiscovery();
      gLastDiscoveryAtMs = nowMs;
    }

    updateTestModeInputs(nowMs);
    servicePendingPirOscReleases(nowMs);
    sendScheduledCommands(nowMs);

    if ((nowMs - gLastStatusPageAtMs) >= kStatusPageIntervalMs) {
      writeOledTestModePage();
      gLastStatusPageAtMs = nowMs;
    }
    return;
  }

  updateSerialConsole();
  updateArtNetInput();
  servicePendingPirOscReleases(nowMs);
  markOfflineClusters(nowMs);

  if ((nowMs - gLastDiscoveryAtMs) >= kDiscoveryIntervalMs) {
    broadcastDiscovery();
    gLastDiscoveryAtMs = nowMs;
  }

  // The original one-by-one boot test remains available in runBootDerekTest()
  // for a future manual trigger. Startup uses the shorter all-up/all-down test.
  runBootMassLiftTest(nowMs);
  sendScheduledCommands(nowMs);

  if ((nowMs - gLastStatusPageAtMs) >= kStatusPageIntervalMs) {
    renderStatusPage(nowMs, kEnablePeriodicSerialStatus);
    gLastStatusPageAtMs = nowMs;
    gCurrentPage = (gCurrentPage + 1) % 2;
  }
}
