MrScottFletcher/project-derek/(commit log)

2026-05-30 Added AGENTS.md file with project info and some Arduino directives.
2026-07-01 Add initial version of Cluster controller PCB
    [BOM_RevD_footprint_matched.csv, BOM_RevE_full_schematic.csv, derek_cluster_controller_revD_220x220_6layer_clean.kicad_sch, derek_cluster_controller_revE_full_schematic.kicad_pcb, derek_cluster_controller_revE_full_schematic.kicad_sch, net_mapping.csv, net_mapping_RevE_full_schematic.csv]
2026-07-03 KiCad PCB files for cluster controller
    [BOM_RevE_full_schematic.csv, Hand_Assembly_BOM.csv, PCBWay_SMT_BOM_DRAFT.csv, derek_cluster_controller_revD_220x220_6layer_clean.kicad_sch, derek_cluster_controller_revE_full_schematic.kicad_pcb, derek_cluster_controller_revE_full_schematic.kicad_sch]
2026-07-03 minor tweak, still not right
    [derek_cluster_controller_revE_full_schematic.kicad_pcb]
2026-07-24 Simplified design to limit SMD and DIP switches
    [BOM_RevD_footprint_matched.csv, BOM_RevE_full_schematic.csv, Hand_Assembly_BOM.csv, Hand_Assembly_BOM_RevG.csv, PCBWay_SMT_BOM_DRAFT.csv, PCBWay_SMT_BOM_RevG.csv, derek_cluster_controller_revE_full_schematic.kicad_pcb, derek_cluster_controller_revG_tht_first.kicad_pcb]
2026-07-25 PCB routing attempt on Mac
    [freerouting.dsn]
2026-07-26 Cleanup some old files, organize.
    [freerouting.dsn]
2026-08-01 Eyeball can PCB v4 sent to PCBWay 2026-08-01
    [Derek_CAN_v4-B_Courtyard.gbr, Derek_CAN_v4-B_Cu.gbr, Derek_CAN_v4-B_Fab.gbr, Derek_CAN_v4-B_Mask.gbr, Derek_CAN_v4-B_Silkscreen.gbr, Derek_CAN_v4-Edge_Cuts.gbr, Derek_CAN_v4-F_Courtyard.gbr, Derek_CAN_v4-F_Cu.gbr]
2026-08-01 Removed cluster KiCad history folder
2026-08-07 New PCB files splitting into two boards
    [BOM.csv, Cluster_Logic_Board.kicad_pcb, Cluster_Logic_Board.kicad_sch, Cluster_Logic_Board.sch, Cluster_Servo_Board.kicad_pcb, Cluster_Servo_Board.kicad_sch, Cluster_Servo_Board.sch, DerekCanLidAssembly_75_v1_Lid_v6.stl]
2026-08-08 Servo Controller board half routed with .4 traces to reduce loss
    [BOM.csv, Cluster_Logic_Board.kicad_pcb, Cluster_Logic_Board.kicad_sch, Cluster_Logic_Board.sch, Cluster_Servo_Board.kicad_pcb, Cluster_Servo_Board.kicad_sch, Cluster_Servo_Board.sch, FOOTPRINTS_REV_B.csv]
2026-08-09 Servo Controller board routed and passes DRC
    [Cluster_Servo_Board.kicad_pcb]
2026-08-09 Starting initial version of Controller Logic PCB
    [BOM_Cluster_Logic_Board_RevC.csv, Cluster_Logic_Board.kicad_pcb, Cluster_Logic_Board.kicad_sch, Cluster_Logic_Board.sch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]
2026-08-09 Anotther initial starting version of Controller Logic PCB
    [BOM_Cluster_Logic_Board_RevC.csv, BOM_Cluster_Logic_Board_RevE.csv, Cluster_Logic_Board.kicad_pcb, Cluster_Logic_Board.kicad_sch]
2026-08-09 YET Anotther initial starting version of Controller Logic PCB
    [BOM_Cluster_Logic_Board_RevG.csv, Cluster_Logic_Board.kicad_pcb, Cluster_Logic_Board.kicad_sch, ESP32_S3_Hosyond_44P_pinmap.csv, U1_Hosyond_Pin_Assignment_Audit.csv]
2026-08-10 REV G version of Controller Logic PCB - might be ready for first attempt at fab
    [Cluster_Logic_Board.kicad_pcb]
2026-08-10 REV G version of Controller Logic PCB - Good gerbers for this version?
    [Cluster_Logic_Board-B_Cu.gbr, Cluster_Logic_Board-B_Mask.gbr, Cluster_Logic_Board-Edge_Cuts.gbr, Cluster_Logic_Board-F_Cu.gbr, Cluster_Logic_Board-F_Mask.gbr, Cluster_Logic_Board-NPTH.drl, Cluster_Logic_Board-PTH.drl, Cluster_Logic_Board-b_silkscreen.gbr]
2026-08-13 REV 4 of CAN (4-layer) board - with correct RJ45 and better power distribution
    [Derek_CAN_v4.kicad_pcb, Derek_CAN_v4.kicad_sch]
2026-08-14 Fixed RJ45 footprints on all, cleaned up routing, ready for a run at PCBWay
    [Cluster_Servo_Board-B_Cu.gbr, Cluster_Servo_Board-B_Mask.gbr, Cluster_Servo_Board-Edge_Cuts.gbr, Cluster_Servo_Board-F_Cu.gbr, Cluster_Servo_Board-F_Mask.gbr, Cluster_Servo_Board-In1_Cu.gbr, Cluster_Servo_Board-In2_Cu.gbr, Cluster_Servo_Board-NPTH.drl]
2026-08-15 Fixed RJ45 footprints on all, cleaned up routing, ready for a run at PCBWay - more
    [Cluster_Logic_Board-B_Courtyard.gbr, Cluster_Logic_Board-B_Cu.gbr, Cluster_Logic_Board-B_Mask.gbr, Cluster_Logic_Board-Edge_Cuts.gbr, Cluster_Logic_Board-F_Courtyard.gbr, Cluster_Logic_Board-F_Cu.gbr, Cluster_Logic_Board-F_Mask.gbr, Cluster_Logic_Board-Margin.gbr]
2026-08-16 Fixed servo controller footprint, submitted to JLCPCB today
    [Cluster_Logic_Board-B_Courtyard.gbr, Cluster_Logic_Board-B_Cu.gbr, Cluster_Logic_Board-B_Mask.gbr, Cluster_Logic_Board-Edge_Cuts.gbr, Cluster_Logic_Board-F_Courtyard.gbr, Cluster_Logic_Board-F_Cu.gbr, Cluster_Logic_Board-F_Mask.gbr, Cluster_Logic_Board-Margin.gbr]
2026-08-20 Added multiple STL and 3mf 3D printing files for safe keeping.
    [Carriage Derek Can Assembly 1 v17 - 1mm new clearance.3mf, Chassis Derek Can Assembly 1 v17 - 1mm new clearance.3mf, Chassis Derek Can Assembly 1 v17 - 1mm new clearance.stl, Chassis Derek Can Assembly 1 v17 - qty07- 1mm new clearance.3mf, Chassis Derek Can Assembly 1 v19 - more space for carriage.3mf, Chassis Derek Can Assembly 1 v19 - more space for carriage.stl, Chassis Derek Can Assembly 1 v1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]
2026-09-03 fix folder structure for Arduino extension
    [derek-cluster.ino, derek-mcu.ino]
2026-09-05 First working test routine on first ever cluster. Woot.
    [partitions.csv]
2026-09-14 Ignore generated build and local IDE files
    [partitions.csv]
2026-09-14 Initial attempt at custom lighting fixture model in QLC+
    [base.obj, head.obj, yoke.obj]
2026-09-16 QLC+ works over wifi to two clusters. Still need clarity on Cluster/Universe sequence. Seems to be based on order of board inits and registration with MCU, and not static. Need to fix that.
    [base.obj, head.obj, yoke.obj]
2026-09-19 Last mostly working version before switching from OSC to ArtNET for more reliable comms with the MCU.
2026-09-22 Art-Net works, updated, fix spotlight grouping, tweaks.
    [derek-cluster.ino, derek-mcu.ino]
2026-09-25 MILESTONE. Everything works OK. v1.5.0. Updates are jerky, but that can be useful. Very snappy.
    [derek-cluster.ino, derek-mcu.ino]
2026-09-26 Smoother movements, slower LED refresh to combat data signal noise, still a bit rough.
    [derek-cluster.ino, derek-mcu.ino]
2026-09-26 Smoother LEDs, a bit herky-jerky, but reliable enough to work with to program shows. At least with 1 universe and 8 Dereks.
2026-09-27 Derek STL file update in 3d-files folder, including wire cover and spot cover, platform.
    [Audio Amp Box A v3.stl, Cluster Board Mount Plate v5 220x220.stl, DerekCan_Platform_75 v5.stl, DerekCan_Platform_75 v5_qty2.3mf, DerekCan_Platform_75_SpotCover_NoOverhang_ v13.stl, DerekCan_Platform_75_SpotWIRECover_v11.stl, Servo Horn EyeCoil_A v8 Flattish.stl, Servo Horn EyeCoil_A v9 CloserToPin.stl]
2026-10-11 Mr. Label 'ethernet' cable labels for 8 universes.
2026-10-28 New remote sequences, fixed the Remote button mapping in QLC+ file.
